jp112sdl/JP6502/Software/README.md

# 6502 system software

This documentation provides necessary insight into software provided in the repository, and it is organized in the following sections:

- [Getting started with provided software](#getting-started-with-provided-software),
- [Building software](#building-software),
- [Detailed description of modules in software folder](#detailed-description-of-modules-in-software-folder).

## Getting started with provided software

Before discussing the details of the contents, I will show how to use sample programs for smoke testing of the soldered board.

I recommend running first couple of programs in slow clock mode, so with external clock module, with Arduino Mega based bus analyzer.

### Connecting Arduino Mega

First, make sure you have the 6502-monitor program installed on your Arduino Mega board. You will find it in `Arduino/6502-monitor` folder.

Connect pins as per following table:

| Expansion port pins | Arduino Mega pins |
| --- | --- |
| D0-D7 (data bus) | 53-39 |
| A00-A15 (address bus) | 52-22 |
| CLK (system clock) | 2 |
| R/W (read/write) | 3 |
| GND | GND |
| +5V | +5V |

**PLEASE NOTE: Connections are reversed for convenience. D0 is connected to pin 53, D1 to pin 51, A00 to pin 52 and A15 to pin 22.**

Also, connect clock module as follows:

| Computer connection | Clock module connection |
| --- | --- |
| CLK input (middle pin on J1) | CLK output |
| UART +5V | +5V |
| UART GND | GND |

It might seem strange that the clock module is powered from UART port, but in fact it doesn't matter which of the power outputs you choose. I use this one, since this one is closes to the clock connector (J1). This is one thing I didn't consider when designing the PCB - I provided GND reference in J1, but the power is missing...

The whole thing will be powered from Arduino via USB - don't worry, the load will not be too high.

### Setting up development environment

Development environment requires the following tools:

- `make` to invoke all the below,
- `cc65` compiler, available [here](https://github.com/cc65/cc65),
- `minipro` software to upload ROM image to EEPROM, available [here](https://gitlab.com/DavidGriffith/minipro/),
- `hexdump` for testing the contents of the binaries,
- `md5sum` to generate binary checksum,
- `rm` and `mkdir` for folder/file manipulation,
- `picocom` for serial communication with the computer (Linux/MacOS),
- `ExtraPuTTy` for serial communication and upload (Windows specific),
- `sz` for loadable module upload via `picocom` (Linux/MacOS),
- `python` to run small utility written in Python to trim loadable modules and add start vector,
- `x6502` to run computer emulator (enables execution of generated binaries on PC), available [here](https://github.com/dbuchwald/x6502) - **please note: this one is optional, still in development, and lagging behind the actual computer.** Simple programs can be executed, but anything more complex than LCD operation (including ACIA/keyboard) don't work just yet.

One important thing to note is that you might need to install FTDI Virtual COM Port drivers, and it applies to all operating systems.

#### Setting up development environment under Linux

By default, Linux distro should contain most of the needed tools. You might need to install `git` to clone `cc65` and `minipro` repositories to build them. The latter requires also `pkg-config` package in Debian/Ubuntu. `sz` might not be available, so check your distro manual for details.

#### Setting up development environment under MacOS

You will probably need `brew` to install `make` and `git`. Tricky part is missing `md5sum` utility, which can be installed using:

```shell
brew install md5sha1sum
```

Other than that, `sz` will probably be missing, so you might need to install this one as well.

#### Setting up development environment under Windows

This one seems to cause most issues, while it's not really that difficult. You need to install [Cygwin](https://cygwin.com/), but while installing, make sure you add the following packages: `python2`, `pkg-config`, `git`, `make`. This should be enough to clone `cc65` and `minipro` repositories, and after building them make sure to issue `make avail` and `make install` respectively to enable invocation from command line.

For serial communication you can use regular PuTTy, but it doesn't have the feature of sending files using XModem protocol, required for loadable module support. Since this is important feature of this hardware/software stack, it's really recommended to use ExtraPuTTy instead.

**PLEASE NOTE:** You might be able to use virtual machines or Windows Subsystem for Linux (WSL) - but neither of the two worked correctly with `make install` target that uses TL866II+ programmer to flash the ROM. YMMV.

### Running the simplest possible program

Now you need to build the first program. Go to `Software/rom/nop_fill` folder and run:

```shell
make clean all test
```

You expect output similar to the following:

```text
$ make clean all test
rm -f ../../build/rom/*.bin \
	rm -f ../../build/rom/*.raw \
	../../build/rom/nop_fill/*.o \
	../../build/rom/nop_fill/*.lst \
	../../build/rom/nop_fill/*.s \
	../../build/rom/nop_fill/*.map \
	../../build/rom/nop_fill/*.d \
	../../build/rom/nop_fill/*.cdep \
	../../build/common/*.o \
	../../build/common/*.lst \
	../../build/common/*.s \
	../../build/common/*.d \
	../../build/common/*.cdep \
	../../build/lib/*.lib
ca65 --cpu 65C02 -Dclock_mode_flag=2  -Dacia_tx_irq=1  -Ddb6502 -I ../../common/include --create-dep ../../build/common/zeropage.d -o ../../build/common/zeropage.o -l ../../build/common/zeropage.lst ../../common/source/zeropage.s
ca65 --cpu 65C02 -Dclock_mode_flag=2  -Dacia_tx_irq=1  -Ddb6502 -I ../../common/include --create-dep ../../build/common/sysram_map.d -o ../../build/common/sysram_map.o -l ../../build/common/sysram_map.lst ../../common/source/sysram_map.s
ca65 --cpu 65C02 -Dclock_mode_flag=2  -Dacia_tx_irq=1  -Ddb6502 -I ../../common/include --create-dep ../../build/rom/nop_fill/nop_fill.d -o ../../build/rom/nop_fill/nop_fill.o -l ../../build/rom/nop_fill/nop_fill.lst nop_fill.s
ca65 --cpu 65C02 -Dclock_mode_flag=2  -Dacia_tx_irq=1  -Ddb6502 -I ../../common/include --create-dep ../../build/common/syscalls.d -o ../../build/common/syscalls.o -l ../../build/common/syscalls.lst ../../common/source/syscalls.s
ca65 --cpu 65C02 -Dclock_mode_flag=2  -Dacia_tx_irq=1  -Ddb6502 -I ../../common/include --create-dep ../../build/common/acia.d -o ../../build/common/acia.o -l ../../build/common/acia.lst ../../common/source/acia.s
ca65 --cpu 65C02 -Dclock_mode_flag=2  -Dacia_tx_irq=1  -Ddb6502 -I ../../common/include --create-dep ../../build/common/blink.d -o ../../build/common/blink.o -l ../../build/common/blink.lst ../../common/source/blink.s
ca65 --cpu 65C02 -Dclock_mode_flag=2  -Dacia_tx_irq=1  -Ddb6502 -I ../../common/include --create-dep ../../build/common/dpad.d -o ../../build/common/dpad.o -l ../../build/common/dpad.lst ../../common/source/dpad.s
ca65 --cpu 65C02 -Dclock_mode_flag=2  -Dacia_tx_irq=1  -Ddb6502 -I ../../common/include --create-dep ../../build/common/core.d -o ../../build/common/core.o -l ../../build/common/core.lst ../../common/source/core.s
ca65 --cpu 65C02 -Dclock_mode_flag=2  -Dacia_tx_irq=1  -Ddb6502 -I ../../common/include --create-dep ../../build/common/keyboard.d -o ../../build/common/keyboard.o -l ../../build/common/keyboard.lst ../../common/source/keyboard.s
ca65 --cpu 65C02 -Dclock_mode_flag=2  -Dacia_tx_irq=1  -Ddb6502 -I ../../common/include --create-dep ../../build/common/lcd.d -o ../../build/common/lcd.o -l ../../build/common/lcd.lst ../../common/source/lcd.s
ca65 --cpu 65C02 -Dclock_mode_flag=2  -Dacia_tx_irq=1  -Ddb6502 -I ../../common/include --create-dep ../../build/common/lcd8bit.d -o ../../build/common/lcd8bit.o -l ../../build/common/lcd8bit.lst ../../common/source/lcd8bit.s
ca65 --cpu 65C02 -Dclock_mode_flag=2  -Dacia_tx_irq=1  -Ddb6502 -I ../../common/include --create-dep ../../build/common/modem.d -o ../../build/common/modem.o -l ../../build/common/modem.lst ../../common/source/modem.s
ca65 --cpu 65C02 -Dclock_mode_flag=2  -Dacia_tx_irq=1  -Ddb6502 -I ../../common/include --create-dep ../../build/common/string.d -o ../../build/common/string.o -l ../../build/common/string.lst ../../common/source/string.s
ca65 --cpu 65C02 -Dclock_mode_flag=2  -Dacia_tx_irq=1  -Ddb6502 -I ../../common/include --create-dep ../../build/common/utils.d -o ../../build/common/utils.o -l ../../build/common/utils.lst ../../common/source/utils.s
ca65 --cpu 65C02 -Dclock_mode_flag=2  -Dacia_tx_irq=1  -Ddb6502 -I ../../common/include --create-dep ../../build/common/via.d -o ../../build/common/via.o -l ../../build/common/via.lst ../../common/source/via.s
ca65 --cpu 65C02 -Dclock_mode_flag=2  -Dacia_tx_irq=1  -Ddb6502 -I ../../common/include --create-dep ../../build/common/via_utils.d -o ../../build/common/via_utils.o -l ../../build/common/via_utils.lst ../../common/source/via_utils.s
ca65 --cpu 65C02 -Dclock_mode_flag=2  -Dacia_tx_irq=1  -Ddb6502 -I ../../common/include --create-dep ../../build/common/vdp.d -o ../../build/common/vdp.o -l ../../build/common/vdp.lst ../../common/source/vdp.s
ca65 --cpu 65C02 -Dclock_mode_flag=2  -Dacia_tx_irq=1  -Ddb6502 -I ../../common/include --create-dep ../../build/common/vdp_text_mode.d -o ../../build/common/vdp_text_mode.o -l ../../build/common/vdp_text_mode.lst ../../common/source/vdp_text_mode.s
ca65 --cpu 65C02 -Dclock_mode_flag=2  -Dacia_tx_irq=1  -Ddb6502 -I ../../common/include --create-dep ../../build/common/sound.d -o ../../build/common/sound.o -l ../../build/common/sound.lst ../../common/source/sound.s
ca65 --cpu 65C02 -Dclock_mode_flag=2  -Dacia_tx_irq=1  -Ddb6502 -I ../../common/include --create-dep ../../build/common/tty.d -o ../../build/common/tty.o -l ../../build/common/tty.lst ../../common/source/tty.s
ca65 --cpu 65C02 -Dclock_mode_flag=2  -Dacia_tx_irq=1  -Ddb6502 -I ../../common/include --create-dep ../../build/common/parse.d -o ../../build/common/parse.o -l ../../build/common/parse.lst ../../common/source/parse.s
ca65 --cpu 65C02 -Dclock_mode_flag=2  -Dacia_tx_irq=1  -Ddb6502 -I ../../common/include --create-dep ../../build/common/menu.d -o ../../build/common/menu.o -l ../../build/common/menu.lst ../../common/source/menu.s
ca65 --cpu 65C02 -Dclock_mode_flag=2  -Dacia_tx_irq=1  -Ddb6502 -I ../../common/include --create-dep ../../build/common/sd.d -o ../../build/common/sd.o -l ../../build/common/sd.lst ../../common/source/sd.s
ar65 r ../../build/lib/common.lib ../../build/common/syscalls.o ../../build/common/acia.o ../../build/common/blink.o ../../build/common/dpad.o ../../build/common/core.o ../../build/common/keyboard.o ../../build/common/lcd.o ../../build/common/lcd8bit.o ../../build/common/modem.o ../../build/common/string.o ../../build/common/utils.o ../../build/common/via.o ../../build/common/via_utils.o ../../build/common/vdp.o ../../build/common/vdp_text_mode.o ../../build/common/sound.o ../../build/common/tty.o ../../build/common/parse.o ../../build/common/menu.o ../../build/common/sd.o
ca65 --cpu 65C02 -Dclock_mode_flag=2  -Dacia_tx_irq=1  -Ddb6502 -I ../../common/include --create-dep ../../build/common/crt0.d -o ../../build/common/crt0.o -l ../../build/common/crt0.lst ../../common/source/crt0.s
cp -f ../../common/none.lib ../../build/lib/common.c.lib
ar65 r ../../build/lib/common.c.lib ../../build/common/crt0.o
ld65  -C ../../common/firmware.ext.cfg -m ../../build/rom/nop_fill/nop_fill.ext.map -o ../../build/rom/nop_fill.ext.bin ../../build/common/zeropage.o ../../build/common/sysram_map.o ../../build/rom/nop_fill/nop_fill.o ../../build/lib/common.lib ../../build/lib/common.c.lib
hexdump -C ../../build/rom/nop_fill.ext.bin
00000000  ea ea ea ea ea ea ea ea  ea ea ea ea ea ea ea ea  |................|
*
00008000
49d01fd92a6a02370364f8eef2ee2c93  ../../build/rom/nop_fill.ext.bin
```

If you remember Ben's video - this is the first program he uploads to ROM. Now, run `make install` to upload the binary to your EEPROM - I assume you put the ROM chip in TL866II+ programmer and it is connected to your machine.

```shell
make install
```

You expect the following output:

```text
minipro -p AT28C256 -w ../../build/rom/nop_fill.ext.bin
Found TL866II+ 04.2.109 (0x26d)
Erasing... 0.02Sec OK
Protect off...OK
Writing Code...  6.78Sec  OK
Reading Code...  0.49Sec  OK
Verification OK
Protect on...OK
```

Plug the ROM back in your board, connect the Arduino to your PC, toggle clock module to manual mode, reset 6502 computer and start serial monitor. Go a few cycles step by step and you should see something similar to the below in serial monitor:

```text
10:13:51.707 -> 000000   1110101011110010   11101010   eaf2  r ea
10:13:52.315 -> 000001   1111111111111111   11101010   ffff  r ea
10:13:52.776 -> 000002   1110101011110010   11101010   eaf2  r ea
10:13:53.201 -> 000003   0000000111111101   10111101   01fd  r bd
10:13:53.585 -> 000004   0000000111111100   10111001   01fc  r b9
10:13:54.074 -> 000005   0000000111111011   10000001   01fb  r 81
10:13:54.576 -> 000006   1111111111111100   11101010   fffc  r ea
10:13:55.562 -> 000007   1111111111111101   11101010   fffd  r ea
10:13:56.020 -> 000008   1110101011101010   11101010   eaea  r ea
10:13:56.511 -> 000009   1110101011101011   11101010   eaeb  r ea
10:13:56.982 -> 000010   1110101011101011   11101010   eaeb  r ea
10:13:57.337 -> 000011   1110101011101100   11101010   eaec  r ea
10:13:57.659 -> 000012   1110101011101100   11101010   eaec  r ea
10:13:57.940 -> 000013   1110101011101101   11101010   eaed  r ea
10:13:58.253 -> 000014   1110101011101101   11101010   eaed  r ea
10:13:58.658 -> 000015   1110101011101110   11101010   eaee  r ea
```

First six lines might be different, but starting from line 7 you should see identical output. If this works, it means your CPU and ROM are working just fine, your clock module and Arduino Mega bus analyzer are attached correctly. Congratulations!

If you have any problems during build, installation or execution - check instructions above again, maybe you missed something.

### More complex programs

After having ran the first one, you can try connecting peripherals to your computer. If you want to follow Ben's videos, keep reading this section, otherwise, skip to [next one](#initiate-warp-speed).

First, let's play with some LEDs. Using the connectors in bottom left corner of the PCB, connect 8 LEDs to VIA2 PORTB lines PB0-PB7, and then, using current limiting resistors of 220Ohm, connect these to ground (also from the VIA2 PORTB connector).

Having these connected, upload `Software/rom/blink_s` to your ROM. After powering on, you should see LEDs blinking in a way similar to what Ben did in his videos. If it works correctly, you can move on to connecting LCD. For now, use it in 8-bit mode with slow clock - just as in Ben's videos.

To do this, connect LCD to breadboard (not to the dedicated LCD port on PCB), and then connect each line as listed below:

| VIA2 Pin | LCD Pin |
| --- | --- |
| PA5 | RS |
| PA6 | R/W |
| PA7 | E |
| PB0 | DB0 |
| PB1 | DB1 |
| PB2 | DB2 |
| PB3 | DB3 |
| PB4 | DB4 |
| PB5 | DB5 |
| PB6 | DB6 |
| PB7 | DB7 |

Also, connect A and VDD connectors to +5V, K and VSS to GND and connect V0 to a middle pin of 10KOhm potentiometer plugged between GND and +5V.

Now upload program `Software/rom/lcd_test` to ROM - when executed, it should display "Merry Christmas!" message on the LCD.

If it works correctly, you have a working CPU, ROM, VIA and address decoder.

### Initiate warp speed

Now it's time to go a bit faster and test the more complex features. Please note: you could keep using the analyzer and external clock with these programs, you just have to remember to build them with `CLOCK_MODE=slow` flag. More details can be found in [building software section](#building-software).

For now let's assume we move to 1MHz clock. To do it, put jumper on two leftmost pins of clock connector (J1). Disconnect external clock and bus analyzer - first one is not needed, second one will not work with high frequencies anyway. Connect your LCD to the onboard LCD port.

First one to test will be serial connection, so upload `Software/rom/serial_wdc_irq`. Now, depending on whether you soldered on FT230X chip or not, connect your board using USB cable to PC (using either MicroUSB or USB-B port), or use external USB->UART connector. Connect to your board using `picocom` with baud rate of 19200.

```shell
picocom -b 19200 /dev/tty.usbserial-HANF88HD
```

When you get "Terminal ready" message, you should see "Hello from WDC65C51 (irq), press any key...". This means that two things are working correctly: interrupt handling and serial communication. The polling counterpart is `Software/rom/serial_wdc`, useful when you want to take the interrupt path out of the picture. Congratulations, you are almost ready to go.

### Keyboard connection

Even if you don't intend to use keyboard just yet, you still need to upload the controller sketch to ATtiny4313. Recommended way of doing that is to use onboard AVR-ISP connector and some kind of AVR programmer. I used USBasp programmer and it works lovely directly from Arduino IDE. The sketch to upload is in `Arduino/keyboard-4313` folder. **PLEASE NOTE:** by default, Arduino IDE will not set fuses of your ATtiny4313 to reflect your clock settings. This can result in unpredictable behavior and/or failure of keyboard connection. Make sure you invoke "Tools->Burn bootloader" before uploading the sketch to ensure correct operation. See [issue #50](https://github.com/dbuchwald/6502/issues/50) for additional details.

After successful sketch upload, flash your rom with `Software/rom/keyboard_test`. Connect your PS/2 keyboard to the port and try pressing some keys - you should see messages on the LCD with confirmation.

### Using the bootloader

Currently only the minimal bootloader is provided, but it should be sufficient for software development without constant need to reflash the EEPROM. To use it, build ROM image in `Software/rom/minimal_bootloader` folder and flash it to EEPROM. To test this functionality, you have to build an example loadable program in `Software/load/hello_world`.

**PLEASE NOTE:** Both the bootloader and sample programs will be built automatically when invoking `make all` directly in `Software` folder.

Upon boot you will be prompted to connect to the PC via serial connection and press Enter key - either in terminal window if keyboard is not connected, or on the keyboard otherwise. Connection details will be displayed on the LCD:

- 19200 baud,
- 8-bit, no parity, 1 stop bit,
- CTS/RTS hardware flow control.

In MacOS/Linux you can use `picocom` for this operation, under Windows I have successfully used [ExtraPuTTy](https://www.extraputty.com/).

After connection is established you need to press enter as prompted (either on PS/2 keyboard or terminal window) and you will be prompted to initiate file transfer. In `picocom` this requires that your send command is set to `sz -X` (see `make terminal` target in `Software/common/makefile`) and you initiate transfer with Ctrl+A followed by Ctrl+S. Enter load file path (i.e. `Software/build/load/hello_world.load.bin`) and press enter. If the transfer fails, try again. `picocom` seems to fail every now and then, while ExtraPuTTy hardly ever has any issues.

In ExtraPuTTy open "Files Transfer" menu item, then "Xmodem" and "Send". Point to loadable module (i.e. `Software/build/load/hello_world.load.bin`) and click "Open" button.

Program should load and be automatically executed. Congratulations, you got yourself working bootloader!

### Installing OS/1

OS/1 is simple operating system, currently being developed for the machine. It already provides bootloader functionality and more is coming every day. **THIS IS WORK IN PROGRESS, SO EXPECT STABILITY ISSUES**

After installing to ROM and booting, it will display basic startup messages on onboard LCD and prompt you to connect via serial port (19200 baud, no parity, 8 data bits, 1 stop bit, CTS/RTS hardware flow control) and confirm connection by sending single char via serial, if no keyboard is connected to PS/2 port or by pressing Enter key on attached PS/2 keyboard otherwise.

Simple prompt will be displayed, and the following commands are currently supported:

- `HELP` - will display simple help message with basic description of the commands,
- `LOAD` - will initiate XModem file receive operation to enable loading loadable modules (see [Using the bootloader](#using-the-bootloader) section for details),
- `RUN` - will run the loaded program,
- `MONITOR` - will run monitor application that can be used to check/alter contents of computer memory,
- `BLINK` - with parameter `ON` or `OFF` will toggle onboard blink LED state,
- `EXIT` - will exit the shell - and go back to it after soft reset.

Loaded programs might fail or fall into infinite loop. To prevent having to reset them, you can press CTRL+X key combination on attached PS/2 keyboard - this will initiate system break operation and should return you back into the shell.

#### Using built-in monitor application

Currently monitor application is fairly limited, but it should provide sufficient functionality for basic troubleshooting. The following commands are supported:

- `GET` with single address (in format `XX` or `XXXX`) will display data from this address and 15 following bytes,
- `GET` with address range (in format `XXXX:XXXX`, zeropage addresses can be substituted with `XX`) will display all the data within given range,
- `PUT` will store provided value (in format `XXXX=XX`) under given address.

Standard commands like `HELP` and `EXIT` are obviously also supported.

## Building software

General rule is simple: `make` should be sufficient for all the build/installation. The following `make` targets are to be used for building software:

- `all` - build the project,
- `clean` - delete all temporary files,
- `test` - dump the contents and checksum of generated binary file,
- `install` - upload generated binary to AT28C256 chip using `minipro` tool,
- `terminal` - connect to the 6502 computer using serial port, please note - currently uses my own device ID as visible under MacOS and most likely needs to be adapted to your build/OS,
- `emu` - run the generated binary in system emulator. Again: suitable for simple programs, more complex ones are not yet supported. So far I needed it only for simple debugging and that's why it is so limited.

Beside the targets, there are three very important build flags:

- `ADDRESS_MODE` - drives the target addressing model by selecting `common/firmware.$(ADDRESS_MODE).cfg`. The only value shipped today is `ext` (also the default if omitted). The `basic` mode for Ben Eater's machine has been **removed**: `common/source/via.s` unconditionally references the third VIA, and the VDP is mapped as well, so `firmware.basic.cfg` had not linked for a long time. If you want to support your own model, create an additional configuration file, as explained in the common sources section below,
- `CLOCK_MODE` - used to control internal delay routines to work with different clock setups. The following modes are supported:
  - `slow` - to be used with external clock module, all delays are basically disabled,
  - `250k` - to be used with Arduino Mega Debugger (my own variant running at approx. 275kHz),
  - `1m` - to be used with 1MHz oscillator,
  - `2m` - to be used with 2MHz oscillator,
  - `4m` - to be used with 4MHz oscillator,
  - `8m` - to be used with 8MHz oscillator.
- `LCD_MODE` - with acceptable values `8bit` and `4bit` (the latter being default if omitted) enables build time selection of LCD interface. If your own build of 6502 computer uses 8-bit interface towards LCD, this will let you use provided software with it. The only thing you might want to check is the LCD data and port definitions at the beginning of `common/source/lcd8bit.s` (or, if you are using your own build with 4-bit mode `common/source/lcd4bit.s`) for symbols `LCD_DATA_PORT` and `LCD_CONTROL_PORT`, as well as their DDR counterparts. The same is possible with 4-bit mode, but there is just one symbol - `LCD_PORT` accompanied by DDR counterpart. Default configuration is obviously immediately compatible with 4-bit onboard LCD connector, and 8-bit interface connected to VIA2 PA for control and PB for data (like in BE6502),
- `ACIA_TX_IRQ` - flag was introduced to enable compatibility with WDC65C51 ACIA chip and acceptable values are `0` and `1`. It controls usage of IRQ request to indicate that transmit operation was completed. When disabled (value `0`), fixed time delay is used to wait for the transmit operation to complete. Rockwell R6551 chips can work with both settings, but `1` is recommended.

Build examples:

```shell
make CLOCK_MODE=slow clean all test install
```

This will build sources with support for slow clocking - any delay routines will be skipped. First, all the binaries will be removed, then built from scratch, hexdump of the resulting binary will be displayed and the binary uploaded to the EEPROM, assuming it's connected via minipro-compatible programmer.

```shell
make CLOCK_MODE=1m all test
```

This command will rebuild only modified modules with support for my own addressing scheme (32K RAM, 24K ROM, VIA at 0x9000) and suitable for 1MHz execution - all delays will be enabled.

## Detailed description of modules in `Software` folder

There are quite many programs in the `Software` folder, making the navigation a bit difficult. This section should support you in navigating provided software library.

### ROM images in `rom` folder

In the `rom` folder you will find the following ROM images:

- `nop_fill` - simplest possible program, composed of 32K of NOP (0xea) instructions. The source itself seems empty, because default fill is defined in the firmware configuration file (`common/firmware.ext.cfg`),
- `blink_s` - first example of a program interfacing with external world, using VIA2 to drive LEDs, as in Ben's videos,
- `blink_c` - modification of `blink_s`, but mixing low-level ASM code for hardware handling and C code for "business logic", shows how to use software stack to write code in C,
- `blink_test` - another blink program, but this one drives the onboard LED through the common library functions instead of touching the VIA directly. The same source is also built as a loadable module, so it doubles as an illustration of what the `BUILD_TYPE=` flag in the `makefile` changes,
- `lcd_test` - modified version of Ben Eater's first LCD program. Modification involves using loops, but runs without RAM, only ROM is used. This program will work only on slow clock (not 1MHz), and will not work with onboard LCD connector. To execute this one, you need to connect LCD via breadboard to VIA2 connectors on the PCB,
- `d_pad_test` - reads the D-pad through the common `dpad` library and reports each direction on the onboard LCD. Built from the same source as `load/d_pad_test`, which is why the folder holds only a `makefile`,
- `keyboard_test` - more complex program presenting integration with onboard keyboard controller, with IRQ driven data transmission, hardware state change detection and pretty interface on the onboard LCD port,
- `serial_test` - simplest possible ACIA/serial testing program, using blocking send/receive operation to send simple message in response to each input on serial terminal,
- `serial_wdc` - ACIA test using polled send and receive, prints "Hello from WDC65C51, press any key...",
- `serial_wdc_irq` - the same test driven by interrupts, prints "Hello from WDC65C51 (irq), press any key...",
- `serial_load_test` - attempt to implement testing program for high serial load, counting incoming characters,
- `modem_test` - barebone modem testing application, sort of bootloader without user interface,
- `play_song` - plays "Mary Had a Little Lamb" on the SN76489, driving the chip directly rather than through the common `sound` library. Shares its source with `load/play_song`,
- `vdp_diag` - reports what the VDP actually does at a cold start, on the **LCD** rather than the screen, because the screen is the part under suspicion. Runs the cold start step by step, then prints text through the same routines BASIC uses, and after each stage checks whether the pattern table in VRAM still matches the ROM. Reach for it before theorising about a bad picture,
- `microsoft_basic` - standalone version of MS Basic interpreter working over serial connection. Loads and saves programs on the SD card - see [BASIC on the SD card](#basic-on-the-sd-card) below,
- `minimal_bootloader` - simplest possible bootloader application that can be used to simplify software development thanks to making ROM flashing unnecessary for each code change,
- `os1` - **work in progress** - basic operating system.

The following table summarizes how each program behaves on this machine. The
`BE6502` column that used to stand next to it is gone with `ADDRESS_MODE=basic`,
which the build no longer supports.

| Program | Execution notes |
| --- | --- |
| `rom/nop_fill` | Works out of the box, slow clock and bus analyzer recommended  |
| `rom/blink_s` | Works out of the box, attach LEDs to VIA2, needs slow clock |
| `rom/blink_c` | Works out of the box, attach LEDs to VIA2, needs slow clock |
| `rom/blink_test` | Works out of the box |
| `rom/d_pad_test` | Works out of the box |
| `rom/lcd_test` | Works out of the box, attach LCD to VIA2, needs slow clock |
| `rom/keyboard_test` | Works out of the box |
| `rom/serial_test` | Works out of the box with R6551, WDC65C51 needs slow clock |
| `rom/serial_wdc` | Works out of the box |
| `rom/serial_wdc_irq` | Works out of the box |
| `rom/serial_load_test` | Works out of the box |
| `rom/modem_test` | Works out of the box |
| `rom/play_song` | Works out of the box, needs the SN76489 fitted |
| `rom/vdp_diag` | Works out of the box, reports on the LCD |
| `rom/microsoft_basic` | Works out of the box |
| `rom/minimal_bootloader` | Works out of the box |
| `rom/os1` | Works out of the box |

### BASIC on the SD card

`rom/microsoft_basic` keeps programs on the card as **plain text**, one BASIC line per text
line, exactly the way `LIST` prints them. There is no tokenised file format: `LOAD` feeds the
file through the interpreter's own line input, and `SAVE` runs `LIST` with the output
redirected. A saved program can therefore be edited on a PC, and it survives changes to the
token table or to the load address.

| Command | Effect |
| --- | --- |
| `LOAD` | read `BASIC.BAS` |
| `LOAD "NAME.BAS"` | read `NAME.BAS` from the root directory |
| `LOAD "$"` | replace the program with a listing of the card, then `LIST` it |
| `LOAD "@"` | replace the program with one sent over the serial port, see below |
| `SAVE "@"` | list the program out over the serial port |
| `SAVE` | write `BASIC.BAS` |
| `SAVE "NAME.BAS"` | write `NAME.BAS` |
| `LOAD "NAME.BAS",8` / `SAVE "NAME.BAS",8` / `LOAD "$",8` | the same with the floppy drive instead of the card, see below |

Both accept any string expression, so `LOAD F$` works too. Names are folded to upper case and
cut down to 8.3; long file names on the card are ignored, only the short name matches.

`LOAD` clears the program first, then inserts every line as if it had been typed - so a text
line without a line number is *executed* rather than stored, and a syntax error stops the load
with the usual message.

`SAVE` creates the file if the card does not have it yet, and it rebuilds the cluster chain
from scratch every time: the old chain is released first, then clusters are taken off the free
list as the listing comes in. The file therefore always ends up exactly as long as the program,
with no leftover tail and no size that disagrees with the chain. Both copies of the FAT are
kept in step, and the free-space fields in the FSInfo block are marked "unknown" afterwards so
a PC counts them again rather than trusting a stale number. A save that fails part way through
gives its clusters back and leaves an empty file rather than something a `chkdsk` would have to
find.

Names that are about to create a new entry are checked first: control characters and the
characters FAT reserves (`" * + , . / : ; < = > ? [ \ ] |`) are refused with `?SYNTAX ERROR`
rather than written into the directory.

Two things the card could do but this does not, on purpose - a 1541 does not do them either,
and the point of `LOAD`/`SAVE`/`LOAD "$"` here is to feel like a C64:

- **one flat directory.** Files live in the root and nowhere else; a subdirectory on the card
  shows up in `LOAD "$"` as `DIR` and cannot be entered,
- **no timestamps.** There is no clock in the machine, and CBM DOS has no date field at all, so
  every entry gets the same fixed stamp of 2026-01-01 12:00. It is there only because a blank
  date field makes some tools on a PC complain.

Actual limitations:

- **the root directory cannot grow.** Once its slots are used up, `SAVE` reports
  `?DIRECTORY FULL` - the same wall a 1541 hits at 144 entries, just at a different number.
  How many depends on how the card was formatted: one entry per 32 bytes of the root
  directory's clusters, and long file names written by a PC eat several entries each.

The card does **not** have to be in the slot when the machine is switched on. `LOAD` and `SAVE`
each bring it up from scratch first - the same sequence that runs at power-on - so a card can
be put in later, taken out and put back, or swapped for a different one between commands. The
swap is the reason this happens every time rather than only after a failure: carrying one
card's layout over to another would have `SAVE` writing over whatever lives at those sector
numbers. It costs roughly 0.4 s per command at 1 MHz, and about twice that for `SAVE`, which
reads the BPB again for the fields the boot-time init does not keep.

Error messages: `?NO CARD`, `?NO SUCH FILE`, `?FILE TOO SMALL`, `?DISK FULL`,
`?DIRECTORY FULL`, `?WRITE ERROR`, `?CARD ERROR`.

The card needs an MBR partition table with a FAT32 partition in one of its four entries, of
type `$0C` (FAT32 LBA, what Windows and most new cards use) or `$0B` (what macOS writes when it
formats a card; `diskutil list` calls it `DOS_FAT_32`). A card formatted without a partition
table is `?NO CARD`, as is one that does not answer. After a `?NO CARD`, `PEEK(73)` says how
far the mount got:

- 100 and up: the card did not come up - 100 plus the number of the command it gave the wrong
  answer to (100 CMD0, 108 CMD8, 155 CMD55, 141 ACMD41), and `PEEK(74)` is that answer, 255
  for none at all. 100 with 255 is also what an empty slot gives.
- 0: its first sector could not be read,
- 1: the first sector has no boot signature,
- 2: no FAT32 partition was found,
- 3: the partition's boot sector could not be read,
- 4 to 7: that boot sector is not one this can use.

A card that came up leaves 7 there. After a failed read (0 or 3), `PEEK(74)` is what the card
sent instead of its answer or the start of the data, 255 for nothing.

A card may take up to 100 ms to deliver a sector. The wait for it is scaled with the clock
the ROM is built for, to the same 320 ms at every clock - it used to be a fixed count, which
was 320 ms at 1 MHz but only 80 ms at 4 MHz, too short for some cards.

The card is driven the way GeckOS does it: CMD0 is sent up to ten times, as some cards ignore
the first ones after power-up; every command - reads and writes of sectors too - is preceded by
a byte of clocks with the card selected and followed by eight clocks with it deselected; and
the two CRC bytes after a sector that is read are clocked out, though not checked. Some cards
do not mind either way; one here, an 8 GB card, missed every command that came without.

**The keyword table used to cap how many statements could exist**, at 256 bytes, because
`program.s` walked it with an 8-bit index and the terminator at offset 256 was unreachable - the
scan looped forever and the machine hung on the first ENTER, with everything up to that point
looking perfectly healthy. The seven places that read it now carry a page alongside the index,
so the cap is gone; section 5.3 of MEMORY_MAP.md has the mechanism. What is left as the real
limit on new statements is the space in front of `EXTCODE` at $e700, which is 1014 bytes since
the XMODEM tables left the ROM - section 5.4 of MEMORY_MAP.md.

**If you extend this code, read [section 5.2 of MEMORY_MAP.md](MEMORY_MAP.md) first.** The body
of `common/source/db6502_sdbasic.s` and the allocating write path at the end of
`common/source/libfat32.s` are deliberately linked into their own ROM block `SDCODE` at `$ec00`
instead of into `CODE`, and their variables into `BASBUF` instead of `BSS`. Growing `CODE` past
roughly `$dc50` moves every library module behind `msbasic.o` to a new address, and on this
board that alone kills the VDP picture - a ROM built from unchanged sources plus 1110 dead
filler bytes reproduces it. That is a hardware-level effect, not a bug in this code.

**Put new code in `EXTCODE2` at `$f900`, and nowhere else.** `SDCODE` and `EXTCODE` are both
full in practice and, more to the point, inserting into either pushes everything behind it to a
new address - which on this board is the failure above. `EXTCODE2` sits behind every other
segment in the image, so an addition there moves nothing at all. It has 1761 bytes free and
`COLOR` is its first tenant, confirmed on the hardware.

That is not a style preference. `COLOR` was first written into `SDCODE`, where its 25 bytes
push the rest of the block up: the machine comes up drawing the right characters through the
wrong glyphs, permanently, and never recovers. The same statement in `EXTCODE2` runs. The
effect is address-dependent rather than size-dependent - `CLS` shifting the same block by 37
bytes is harmless, 62 bytes is not - so there is no safe amount to insert. Sections 5.1.1 and
5.2.3 of MEMORY_MAP.md have the measurements, including what has already been ruled out on the
hardware so it does not get chased again.

`LOAD "$"` ends the way a C64 directory does, with a line saying how much room is left:

```text
0 "SD CARD"
1 "HELLO.BAS        1"
2 "PROG.BAS         6"
3 "78566 BLOCKS FREE"
```

A block is 512 bytes, the same unit the size column uses. The figure comes out of the FSInfo
block rather than from counting the FAT - on an 8 GB card that count would mean reading some
eight thousand sectors, about thirteen minutes. `SAVE` therefore keeps the FSInfo count in step
as it takes and returns clusters, instead of marking it unknown; `fsck_msdos` confirms the
number afterwards. A card that arrives without a usable count is told apart from one with a
real zero: the line then reads `??? BLOCKS FREE`.

### Sending a program over the serial port

`LOAD "@"` takes the program from the ACIA instead of the card, and `tools/basicsend.py`
sends it from the Mac over an FTDI cable. It is the same plain text again - the same lines
`LIST` prints, the same lines a `.BAS` file holds - so a program can be written in a proper
editor, sent over, tried out, edited on the machine and saved to the card, with nothing
converted anywhere along the way.

```bash
./tools/basicsend.py SNAKE.BAS
```

Then type `LOAD "@"` on the machine. `SAVE "@"` sends a program the other way,
with `tools/basicrecv.py` catching it:

```bash
./tools/basicrecv.py SNAKE.BAS
``` Either order works: the receiver repeats its "ready"
every half second while it waits, so the tool picks one up whenever it arrives. The status
line counts the lines as they land, and `OK` comes back when the last one is in.

The tool takes a path, or a bare name it looks up in `basic/`:

| | |
| --- | --- |
| `basicsend.py --list` | what is in `basic/`, with line and byte counts |
| `basicsend.py HANOI.BAS` | send it |
| `basicsend.py -p /dev/tty.usbserial-XXXX prog.bas` | pick the port by hand |
| `basicsend.py --as-is prog.bas` | do not touch the case of anything |

`basicrecv.py` refuses to overwrite a file unless you pass `-f`, and writes nothing at all if
the listing stops without its end marker - half a program looks exactly like a whole one, and
under the name of the real thing it would be worse than none. `-` writes to standard output
instead of a file. Ctrl+C on the machine gets it out of a `SAVE "@"` with nothing listening.

By default the sending tool upper-cases everything outside string literals, because the tokeniser only
knows upper case keywords - `10 print "hello"` would be a syntax error, and `10 PRINT "hello"`
is what you meant. Blank lines are dropped, and a line over 78 characters is refused before
anything is sent rather than being silently cut short at the far end.

`LOAD "@"` runs `NEW` first, exactly as `LOAD` from the card does, so what arrives replaces
what was in memory. A line without a line number is *executed* rather than stored, and a
syntax error ends the transfer with the usual message - the tool is told and stops rather than
sitting out its timeout. Ctrl+C on the machine also ends it.

One line at a time, each acknowledged before the next is sent. That is not for the sake of the
wire - 19200 baud is nothing - but because inserting a line into a long program takes longer
than sending one, and streaming would overrun the 256 byte receive buffer inside a second.

Nothing appears on the machine until the tool has the port open, and that is the hardware
rather than the software: the 6551 holds its transmitter off while `/CTS` is high, and `/CTS`
comes from the far end's RTS. So `LOAD "@"` on its own sits quietly at `000` until something
opens the port. Ctrl+C gets you out of it at any point, and starting a fresh `LOAD "@"` throws
away anything a previous attempt left on the wire - no power cycle needed in between.

### The floppy drive: `LOAD "NAME.BAS",8`

With `,8` behind the name, `LOAD`, `SAVE` and `LOAD "$"` go to a floppy drive instead of the
card - device 8, the way a C64 has its 1541:

```basic
LOAD "$",8
LIST
LOAD "HELLO.BAS",8
SAVE "HELLO.BAS",8
```

The drive is a PC floppy with a Raspberry Pi Pico as its controller, on the 6551 through a
switch that otherwise connects the FTDI. The wiring, the protocol and the state of the
build are in [`../Schematics/FLOPPY_PICO.md`](../Schematics/FLOPPY_PICO.md). It speaks the
protocol of `LOAD "@"` and `SAVE "@"` with a command in front, and answers like a 1541:
anything that goes wrong shows up as `?62,FILE NOT FOUND`, `?72,DISK FULL`,
`?26,WRITE PROTECT ON` and so on, on the screen and the LCD. A drive that does not answer
within about ten seconds - the switch on the Mac side, say - is `?DEVICE NOT PRESENT`.
Files are text, as on the card, and the same name rules apply.

Until the drive is built, `tools/drivesim.py` plays it with a folder on the Mac, over the FTDI
with the switch on the Mac side:

```
./tools/drivesim.py                    # serves basic/
./tools/drivesim.py -p /dev/tty.usbserial-XXXX ~/floppy
./tools/drivesim.py -v                 # log every byte on the wire
```

As with `LOAD "@"`, the 6551 sends nothing until the tool has the port open, and on the Mac
the first byte after that is lost. So once the port has settled the tool sends ENQ, and BASIC,
if it is waiting for an answer, sends the command again - the tool may be started before the
command or within the ten seconds BASIC waits.

It treats the folder as a 1.44 MB disk, so `LOAD "$",8` shows how much of that is left and a
save that does not fit gets `?72,DISK FULL`. With `--stdio` it talks over standard input and
output instead, which is how the GeckOS emulator runs it:
`jp6502emu -A "tools/drivesim.py --stdio basic" build/rom/microsoft_basic.ext.bin`.

### The `SOUND` statement

`rom/microsoft_basic` adds one statement to the interpreter beyond `LOAD`, `SAVE` and `EXIT`:

```basic
SOUND frequency, duration
```

`frequency` is in Hz, `duration` in hundredths of a second. The note plays on channel 1 of the
SN76489 at full volume, and `SOUND` returns once it has finished, so notes queue up naturally:

```basic
10 FOR N=1 TO 8
20 READ F
30 SOUND F,25
40 NEXT N
50 DATA 262,294,330,349,392,440,494,523
```

The chip is not given a frequency but a 10 bit divider, and the note it produces is
`clock / (32 * divider)`. The SN76489 runs on the same oscillator as the CPU, so the clock is
the one the ROM is built for (`CLOCK_MODE`), and `SOUND` works the divider out for it - at
4 MHz that is `125000 / frequency`. A divider outside 1..1023 is `ILLEGAL QUANTITY`, which
puts the usable range at **122 Hz to about 8 kHz at 4 MHz** (31 Hz to 2 kHz at 1 MHz, 61 Hz
to 4 kHz at 2 MHz); towards the top end the steps between neighbouring dividers get audible.
The note table in `common/include/sound.inc`, which the startup chord and the OS/1 `BEEP`
play from, is worked out for the clock the same way.

The port directions are set up by `sound_init` during `_system_init`, long before the `OK`
prompt, so nothing has to be prepared first. Every `SOUND` mutes the channel again when it
returns.

The speaker is in series with a MOSFET (2N7000), whose gate is pulled up with 10k and pulled
down by a second 2N7000 whose gate is CB2 of VIA2 - an inverter: CB2 high or not driven is
off, low is on. After a reset CB2 is an input, pulled up with 10k (a 6522 other than the
W65C22S has a pull-up of its own there, which is why a pull-down on the switch did not work),
so the speaker stays off while the SN76489 plays whatever its registers came up with;
`sound_init` silences the chip and only then drives CB2 low. A 100µF capacitor in front of the
speaker keeps DC out of it, 10k from its minus side to ground keep it charged while the
speaker is off, and 100Ω in series keep the output of the chip near the 10 mA it is rated
for. A ROM that does not drive CB2 low stays silent.

Channels 2 and 3 and the noise generator are not reachable from BASIC. They are one `POKE` away
though - `PORTA` at 34817 carries the data bus and `PORTB` at 34816 the write strobe:

```basic
900 POKE 34817,B : POKE 34816,2 : POKE 34816,0 : POKE 34816,2 : RETURN
```

Add 32 for channel 2, 64 for channel 3 and 96 for noise to both the latch byte
(`128 + (N AND 15)`) and the volume byte (`144` for full, `159` for off).

### Example programs in the `basic` folder

`basic/HANOI.BAS` is plain text in the format `LOAD` expects, so it goes onto the card as it
is. Towers of Hanoi for 3 to 7 disks: pick `P` and you move the disks yourself, pick `W` and
the machine solves it in front of you. The pegs are drawn after every move and the SN76489
clicks as each disk lands, lower disks on a lower note.

```
   |       |       |
  ***      |       |
 *****     |       *
------- ------- -------
   1       2       3

 1 MOVES SO FAR, 7 IS THE BEST
FROM,TO (0,0 GIVES UP)? 1,3
A DISK CANNOT SIT ON A SMALLER ONE.
```

Two things in it are worth reading if you write BASIC on this machine.

The watch mode has no recursion to work with - `GOSUB` takes no arguments and keeps no locals -
so the frames of the usual `hanoi(k, from, to, via)` live in five arrays (`SN`/`SA`/`SC`/`SB`)
with a stage number `ST` per frame: 0 means the disks above still have to be cleared away, 1
that the big disk can move now, 2 that the frame is done.

The move checker tests one thing per line and leaves as soon as something is wrong, rather than
writing the conditions as one expression. `AND` here does not short-circuit, so a typed `4,1`
in `IF ER=0 AND H(FP)=0` would still evaluate `H(4)` and stop the program with `?BS ERROR`.

Nothing in it needs anything this BASIC does not have. `CONFIG_SMALL` removes `GET`, there is
no `ELSE` and no `STRING$`, so input is line-based, every branch is a line number and the
padding strings are built with `FOR` loops.

### The `CLS` statement

`CLS` clears the screen and puts the cursor in the top left corner. It takes no arguments.

It is not what `CLEAR` does. `CLEAR` is stock MS-BASIC and has nothing to do with the display:
it throws away every variable and array, hands the whole of string space back, resets the
`DATA` pointer and unwinds the `FOR` and `GOSUB` stacks. The program text survives. Reach for
it when a program has filled memory with strings, not when the screen is untidy.

`tty_config` can have more than one output switched on, so `CLS` treats each one on its own
terms: the VDP has a routine for it, and a serial terminal is sent `ESC[2J ESC[H`. That escape
sequence goes straight to the ACIA rather than through the console writer, which would put the
bracket and the letters on the VDP as text as well. The LCD is left alone - it is the panel,
not a console.

### The `COLOR` statement

```basic
COLOR foreground, background
```

Both are 0 to 15 out of the TMS9918A palette. Text mode has no colour table, so the background
is the backdrop and these two are the only colours on the screen. Anything above 15 wraps.

| | | | |
|---|---|---|---|
| 0 transparent | 4 dark blue | 8 medium red | 12 dark green |
| 1 black | 5 light blue | 9 light red | 13 magenta |
| 2 medium green | 6 dark red | 10 dark yellow | 14 gray |
| 3 light green | 7 cyan | 11 light yellow | 15 white |

`COLOR 15,4` is what the machine starts with.

**This is one of the few things `POKE` cannot do.** Both halves of a VDP register write go to
the same control port at 32897, so `POKE 32897,246 : POKE 32897,135` looks like it should set
register 7 - and it does nothing at all, without an error. `POKE` assembles to
`sta (LINNUM),y`, and the dummy read that addressing mode performs on the target one cycle
before the write is itself a VDP access. The chip wants about 8 µs between two, so the write
is lost and the pair never completes. It is the same access time that used to leave the screen
dark at cold start. `COLOR` goes through `vdp_write_register`, which waits between the halves.

### Graphics mode: `SCREEN` and `PLOT`

```basic
SCREEN 0            back to text, 40x24
SCREEN 1            graphics, 256x192

PLOT x, y, colour
LINE x1, y1, x2, y2, colour
CIRCLE x, y, radius, colour

SPRITE n, x, y, pattern, colour
VPOKE address, value
```

`x` is 0 to 255, `y` is 0 to 191, `colour` is 0 to 15 out of the palette listed under
`COLOR`. Colour 0 clears the pixel and leaves the background showing; 1 to 15 set it.

```basic
10 SCREEN 1
20 FOR X=0 TO 255
30 PLOT X, 96+SIN(X/16)*80, 15
40 NEXT X
```

**One colour per eight pixels.** The TMS9918A stores a foreground and a background colour for
each horizontal run of eight pixels, not for each pixel. Plotting a red dot therefore recolours
whatever else is already lit in the same group of eight. There is no way around it short of a
full off-screen copy of the screen, and this machine has no 6 KB of RAM to spare for one. The
background stays black, the way `SCREEN 1` leaves it.

```basic
10 SCREEN 1
20 CIRCLE 128, 96, 60, 15
30 PRINT "TEXT AND PICTURES AT ONCE"
```

**Sprites** are 8x8 and unmagnified, which leaves 256 shapes in the 2 KB at $1800 and keeps one
shape down to eight bytes. `n` is 0 to 31; `y` of 192 or more parks a sprite off the screen,
which is how one is hidden. `SCREEN 1` parks all 32 and blanks the shapes, so nothing appears
until you put it there.

Shapes go in with `VPOKE`, one byte at a time, because `POKE` cannot reach VRAM at all - the
reason is under `COLOR` above. Pattern `p` lives at `6144 + p*8`:

```basic
10 SCREEN 1
20 FOR I=0 TO 7
30 READ B : VPOKE 6144+I, B
40 NEXT I
50 DATA 60,126,219,255,189,195,102,0
60 FOR X=0 TO 248
70 SPRITE 0, X, 90, 0, 15
80 NEXT X
```

`VPOKE` writes anywhere in the 16 KB of VRAM, so it also reaches the bitmap, the colour table
and the sprite attributes. That is useful and it will take the display apart just as readily as
`POKE` takes the machine apart.

Two details of the chip are dealt with rather than passed on: a sprite appears one line below
the `y` in its attribute entry, so the stored value is one less than you asked for; and a stored
`y` of 208 tells the chip to stop reading the table there, which would silently switch off every
sprite after it, so that one value is nudged by a line. What is not dealt with, because it
cannot be, is that only four sprites are drawn on any one scanline. The fifth simply is not
there.

**The console keeps working in graphics mode.** The bitmap occupies the VRAM the font lives in,
so the two cannot both be the screen - but the font is still in the ROM, and characters are
drawn into the bitmap instead, eight bytes at a time. `PRINT` works, and so does seeing what
you type.

The cell layout falls out of the bitmap addressing: for a character at column `c` and row `r`
the eight rows of pixels are eight consecutive VRAM addresses, so one address gets written and
eight bytes go out. The colour is written too, so text stays readable over whatever was drawn
underneath.

32 columns by 24 rows, against 40 by 24 in text mode. **It scrolls, and it is slow.** A
character row is exactly one 256-byte page of the bitmap, so moving the picture up a row is 23
page moves in the shape table and 23 in the colour table - 11776 bytes through the processor
twice, about a third of a second. There is no way round it: the 9918 has no block move, and in
this mode every cell has its own pattern, so the name table cannot be rotated the way it can on
a text screen. What you see is the copy sweeping down the screen, which reads as the scroll it
is.

If a third of a second a line is too slow - a long `LIST` is the case that hurts - the jump is
one constant, `GTX_SCROLL_ROWS` in `db6502_extra.s`. Jumping further moves nearly the same
bytes but does it once every that many lines, so the cost per line falls with the jump: about
90 ms at four rows, about 45 ms at eight. The screen then jumps rather than slides.

`SCREEN 0` reloads the font and goes back to the 40 column text screen; so does the reset
button, and after a power-on the console is always the text one.

`LINE` takes both endpoints inclusive and is Bresenham, so it never strays more than half a
pixel from the true line. `CIRCLE` is the midpoint algorithm and holds to the same half pixel.
Both cost what `PLOT` costs, per pixel drawn.

A circle may sit anywhere, including partly off the screen - it is clipped point by point and
drawn as far as it fits. `CIRCLE x, y, 0, c` is one dot.

```basic
10 SCREEN 1
20 FOR R=8 TO 88 STEP 8
30 CIRCLE 128, 96, R, 15
40 NEXT R
```

**Speed.** A single `PLOT` is a read-modify-write of the bitmap byte plus a write to the colour
table, three VRAM addresses in all, about 250 µs. That is roughly 4000 pixels a second, so the
example above draws in about a fifteenth of a second, a full width `LINE` takes about 64 ms,
and filling the whole screen dot by dot would take ten seconds. `SCREEN 1` itself writes 13056
bytes and takes about a quarter of a second, with the screen blanked while it does.

Runs of eight pixels that fall inside one byte could be written whole - two VRAM addresses
instead of twenty-four, worth roughly a factor of thirteen on horizontal lines. That is not
implemented. It is not as simple as it sounds: in this mode consecutive bytes are eight
addresses apart rather than adjacent, so it does not fall out of the VDP's auto-increment and
needs its own path with masked ends.

The VRAM layout is the usual full-screen bitmap: 6144 bytes for the bitmap at $0000, 6144 for
the colour table at $2000, 768 for the name table at $3800. Sprites are switched off by putting
$D0 in the first sprite's Y byte - the attribute table is not part of what `SCREEN 1` fills, and
an uninitialised one has the chip drawing 32 sprites out of whatever the VRAM came up with. The
2 KB hole between the bitmap and the colour table, $1800-$1FFF, is where a sprite pattern table
would have to go: those need a 2 KB boundary, so the space behind the name table cannot hold
one.

### The `KEY` function

```basic
A = KEY(0)
```

The code of a key if one is waiting, zero if none is. It does not wait, which is the whole
point: `INPUT` holds the machine until ENTER, so without this nothing written in BASIC can
steer a sprite, poll for a fire button, or offer a way out of a loop.

The argument is required by the way MS-BASIC dispatches functions and is ignored, the same way
`RND(0)` reads.

Both the serial port and the PS/2 keyboard feed it. Print the codes to find out what your
keyboard sends:

```basic
10 K=KEY(0)
20 IF K>0 THEN PRINT K
30 GOTO 10
```

Upstream MS-BASIC has `GET` for this, but `CONFIG_SMALL` leaves its routine out of the build
entirely, so restoring the keyword would mean compiling the routine and growing `CODE` - see
section 5.2.3 of MEMORY_MAP.md for why that is the one change to avoid.

### The console

40 columns by 24 rows in text mode, 32 by 24 in graphics. A line that runs off the right edge
wraps onto the next row, and the screen scrolls when it runs off the bottom - in graphics mode
that scroll costs about a third of a second, see the note under the graphics statements.

`PRINT` counts its own columns for the comma and `TAB` zones, and knows nothing about the
console, so a very long line can wrap somewhere the zones did not expect.

### Stopping a program

`Ctrl+C` breaks a running program and a running `LIST`, and prints `BREAK IN` with the line
number. `CONT` carries on from there.

`Ctrl+X` is a different thing entirely and lives a level lower: the keyboard controller sends
`$18` for it, the interrupt handler picks that off before it ever reaches the input buffer, and
the machine restarts. It works no matter what BASIC is doing, including inside a `SOUND` that
has not finished, which `Ctrl+C` cannot do - the check happens between statements.

### The d-pad

Four buttons on VIA2 port B, active low, so a pressed button reads as a zero bit. Nothing has
to be set up first - `_blink_init` runs during boot and leaves those bits as inputs.

```basic
B = PEEK(34816)
IF (B AND  8)=0 THEN REM up
IF (B AND 64)=0 THEN REM down
IF (B AND 16)=0 THEN REM left
IF (B AND 32)=0 THEN REM right
```

`(B AND 120)=120` is "nothing pressed", which makes a serviceable "press any key to start" and,
counted round a loop, a seed for `RND`. Bit 7 is the LED and bits 0 and 1 are outputs as well -
writing to the port will turn the LED on and off, and is otherwise best left alone.

`basic/DPAD.BAS` steers a sprite with it, which is about twenty lines. `basic/SNAKE.BAS` is a
game on the graphics screen: the field is 8x8 cells, and each one is drawn with eight `VPOKE`s
rather than sixty-four `PLOT`s, because a character row of the bitmap is one page of VRAM and
its eight rows of pixels are eight consecutive addresses. Collisions come out of an occupancy
array rather than by walking the body, so a long snake costs no more per move than a short one.

Sprites are the fast way to move something: two bytes go to the attribute table and the chip
does the rest, where the same movement drawn into the bitmap is a few hundred writes. What they
will not do is a snake - only four sprites appear on any one scanline, and a snake lying flat
is a row of segments on the same line.

### Cold start and warm start

After a **power-on** the machine goes straight into a cold start. There is nothing else it
could sensibly do: the SRAM comes up holding whatever it feels like, so there is no program to
keep and no prompt worth showing.

After a **reset** the RAM still holds the program that was in it, and there the choice matters,
so the question comes back:

```text
Cold start [C] or warm [W] start?
```

`C` clears the program and starts fresh, `W` keeps it and returns to the `OK` prompt.

The two cases are told apart by a six-byte signature in `BASBUF`, stamped on the way into the
first cold start and never cleared afterwards. Finding it again means the RAM survived, which
means this was a reset. `BASBUF` works for this because nothing zeroes that page at boot - the
same property that forces `_start_msbasic` to set `sd_loadmode` and `sd_savemode` by hand.

Six bytes of ASCII rather than a two-byte bit pattern on purpose: an SRAM does not come up
uniformly random, it comes up in patterns, and a short signature built from the kind of bytes
an SRAM likes is exactly the one that appears by accident and sends the machine into a warm
start over garbage.

### The panel

The 20x4 LCD is a four line panel, and the LED behaves like the one on a 1541 - lit while the
card is in use, out again when the command finished, still lit if it did not:

```text
Microsoft BASIC
21817 BYTES FREE
SD READY
SAVE PROG.BAS   120
```

The banner and the free memory line are repainted at every direct mode prompt, so the panel
puts itself back together after anything that disturbs it; the card line follows each mount,
and the bottom line follows the transfer. `BYTES FREE` is the figure `PRINT FRE(0)` gives.

The counter is lines: read for `LOAD`, written for `SAVE`, listed for `LOAD "$"`. Lines rather
than 512 byte blocks because that is the unit these files come in - a BASIC program of a few
hundred bytes is nought blocks from beginning to end, and a counter that never moves is worse
than no counter. It sticks at 999. Column 19 is
never written: reaching the end of the last row makes `lcd_wrap_line` scroll the whole display
and wait 150 ms, which would throw the line away and make every update slow. For the same
reason the cursor is parked at the top of the display before the card is touched - `sd_init`
prints `SD not initialized` wherever the cursor happens to be.

### Loadable programs in `load` folder

All the programs in the `load` folder are to be uploaded to the 6502 computer over serial port with XMODEM protocol and require ROM to be flashed with software capable of receiving them. Currently this is `rom/modem_test` and `rom/minimal_bootloader`. Following list describes them in more detail:

- `load/d_pad_test` - exercises the D-pad through the common `dpad` library and reports what it reads on the onboard LCD. Also built as a ROM image by `rom/d_pad_test` from this same source,
- `load/hello_world` - simple program to illustrate difference between assembly and C code,
- `load/hello_world_c` - as above, but written in C,
- `load/monitor` - work in progress implementation of the monitor program (moved to OS/1 image),
- `load/play_song` - plays "Mary Had a Little Lamb" on the SN76489. It talks to the chip itself and only takes the bit definitions from `sound.inc`, so it does not depend on the common `sound` library. Also built as a ROM image by `rom/play_song`,
- `load/sysinfo` - simple program to display system information, now embedded in OS/1 image.

As for software compatibility - all the loadable modules require bootloader, and this one, in turn, requires ACIA for operation, so by design these are not compatible with vanilla BE6502.

### Loadable modules explained

There is one thing important to consider when working with loadable modules. The idea behind them is to have the possibility to run the same code from RAM and ROM, preferably preserving the former if possible and reducing the loadable file size. The idea is to be able to execute common functions stored in ROM from the code running in RAM.

The naive approach is to bundle every function the module calls into the module
itself. It works, and it is what you get without doing anything special, but the
binary then carries its own copy of code that already sits in ROM, and a ROM
update leaves that copy behind.

The alternative is what `load/hello_world` does. It calls `writeln_tty`, so it
uses `_tty_writeln` from the common library - and the whole binary is 286 bytes,
nowhere near enough to contain it. None of the common code is bundled. The
references are satisfied by stub functions defined in `common/source/loadlib.s`,
each of which is a jump through a vector in the dedicated range in ROM
(0xf800-0xfff9). This indirection layer enables updates to ROM without needing
to recompile all the loadable modules. The only requirement is to keep the order
of the calls intact and to add new functions to `common/source/syscalls.s` at the
end, so that previously defined addresses stay where they are.

Defining new shared function requires the following:

- implementation of the code in `common/source` folder,
- implementation of the interface include in `common/include` folder,
- adding this new function to `common/source/syscalls.s` module,
- adding stub function to `common/source/loadlib.s` module,
- adding new objects to `rom/minimal_bootloader/makefile` and `rom/modem_test/makefile`.

The list above should help you understand how this code reusability has been achieved.
