jp112sdl/JP6502/images/breadboard_crop.jpeg

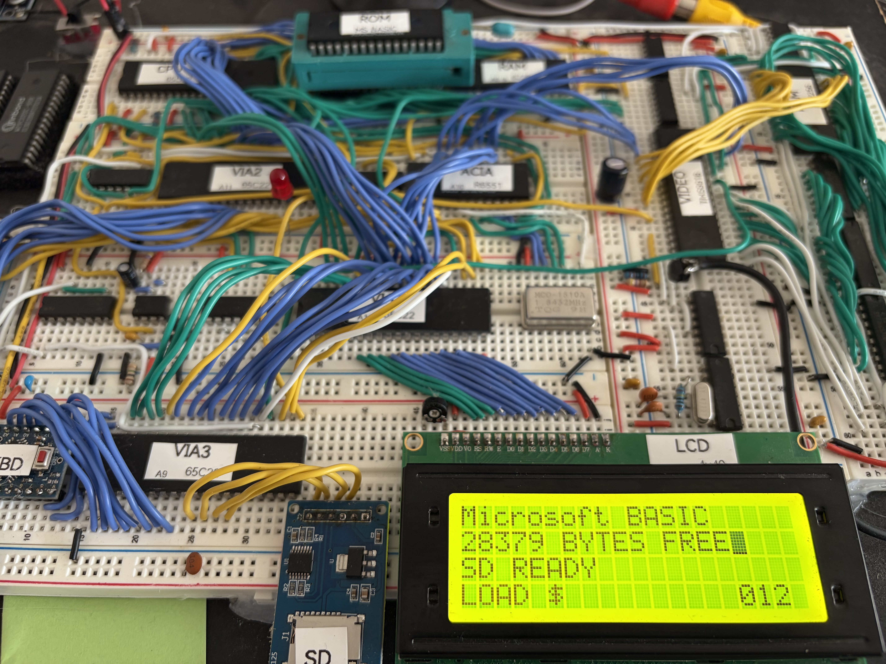
images/breadboard_crop.jpeg
