jp112sdl/JP6502/(commit log)

2026-08-08 jp modsupdate kicad version
2026-08-08 update code
    [firmware.ext.cfg, load.cfg]
2026-08-08 Phase1 done
    [firmware.ext.cfg]
2026-08-11 Add SD card LOAD/SAVE to MS-BASIC, with a drive light and status panel
    Programs live on the card as plain text, one BASIC line per text line,
    exactly the way LIST prints them - LOAD feeds the file through the
    interpreter's own line input and SAVE runs LIST with the output
    redirected, so a saved program can be edited on a PC.
    LOAD / LOAD "NAME.BAS" read a file
    LOAD "$" list the card, ending on a BLOCKS FREE line
    SAVE / SAVE "NAME.BAS" write a file, creating it if it is not there
    SAVE rebuilds the cluster chain from scratch every time: the old chain is
    released first, then clusters are taken off the free list as the listing
    comes in, so the file is always exactly as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
    [applesoft.cfg, cbmbasic1.cfg, cbmbasic2.cfg, firmware.basic.cfg, firmware.ext.cfg, kb9.cfg, kbdbasic.cfg, microtan.cfg]
2026-08-11 Auto-confirm the MS-BASIC startup prompts and share init.s
    Cold start asked "MEMORY SIZE" and "TERMINAL WIDTH" on every boot. Both
    questions only make sense on a machine whose RAM size and terminal are
    unknown at build time - here the memory map is fixed and WIDTH/WIDTH2
    are set in defines_db6502.s, so the answer was always an empty line.
    CONFIG_NO_INIT_PROMPTS now skips both blocks and lets the code fall into
    the RAM probe, which is exactly what confirming with Enter did. Frees 99
    bytes in the ROM build.
    That made the missing DB6502 hard limit in the loadable build's copy of
    init.s a real problem rather than a latent one: with no prompt there is
    no way to answer with a number any more, so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
2026-08-15 Add an XMODEM/CRC uploader for the minimal bootloader
    Sends the .load.bin files from build/load to the 6502 over the serial
    port, driving the receiver in common/source/modem.s.
    That receiver is not quite stock XMODEM, so a generic tool does not work
    against it. Three details it gets wrong:
    * A block is 133 bytes on the wire, not 132 - modem.s reads 132 bytes
    after the SOH (block number, its complement, 128 data bytes, two CRC
    bytes).
    * The handshake is not "wait for a C". The prompt modem.s prints
    contains the letter twice in "XMODEM/CRC", so a tool watching for a
    bare C starts transmitting in the middle of the prompt. This one
    waits for the C that follows the promp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
    [xmodem_send.py]
2026-08-15 Rewire the ATtiny keyboard controller and add a German keymap
    The controller now talks to the VIA on different pins: data on PD3,
    IRQ on PD2, the handshake lines on 9 and 8, and the eight data lines
    reversed to {17..10}. The previous assignment did not match the wiring
    on this board.
    PS2Keymap_German is added and made the default for begin(), and the US
    map is corrected to lower case letters - the shifted variants are what
    the shift table is for, so the unshifted table was producing capitals
    for every key. Enter stays PS2_ENTER (13), which is the KEY_ENTER the
    6502 side expects in common/include/keyboard.inc.
    Also ignore __pycache__, now that there are Python tools in the tree.
    Co-Authore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
2026-08-15 Ignore .hex build output
    The Arduino toolchain drops .hex files next to the sketch on every
    build, and no .hex is versioned here.
2026-08-16 Record that any relocation in the BASIC ROM kills the display
    Section 5.2 already said this board fails when library modules move, but
    worded the rule as a size threshold: "grows past $DC50". That is wrong.
    Removing a 3 byte jsr from _system_init made CODE shrink, so it stayed
    far below any threshold, and the screen went black anyway. Reproduced
    over two flashes, with the unchanged ROM and a byte stable version of
    the same change both running - which also rules out a bad EEPROM burn.
    Three bytes less in core.o move every library module behind it: 7281
    changed bytes in CODE, 1493 in RODATA, 389 in BAS_*, 68 in SYSCALLS and
    one in VECTORS. Page alignment kept RODATA_PA in place and that did n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
2026-08-16 Drop the boot time SD mount
    _sd_mount runs the whole bring-up itself - it resets the card to idle
    and SPI mode and re-reads the layout - and LOAD and SAVE call it every
    time rather than trusting what the last access saw. Mounting at boot as
    well bought nothing and cost the card timeout on every reset with an
    empty slot, plus an "SD initializing" line on the LCD.
    OS/1 is the exception: its shell loads programs with _sd_load, which
    only tests sd_ready and never mounts, so the call moves into os1.s
    instead of disappearing.
    The three bytes the jsr occupied are padded with nop. core.o sits in
    common.lib ahead of most other modules, so shortening it relocates every
    library module in the BASIC RO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
2026-08-16 Light the drive LED through the BASIC cold start
    The RAM probe walks all of user RAM a byte at a time and the vector
    setup after it takes a while too, so the machine looks dead between the
    "C" and the first prompt. The drive light doubles as a busy light for
    that stretch.
    Both new routines sit at the end of EXTCODE and are reached by swapping
    an existing call for one of the same width - JMP COLD_START becomes JMP
    sd_coldstart, jsr sd_panelprompt becomes jsr sd_promptled. Only two
    operands change, no byte in CODE or SDCODE moves. See MEMORY_MAP.md
    5.2.1 for why that matters here.
    sd_promptled leaves the light alone while a save is still open, since
    sd_finish is about to close that file and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
2026-08-16 Keep the OS/1 ROM byte stable as well
    Adding a second "jsr _sd_init" next to "jsr _system_init" grew os1.o by
    three bytes and moved shell.o, monitor.o, opcodes.o and the whole
    library behind it. That is the change this board reacts to, so OS/1 was
    carrying the same defect the BASIC ROM had just been cured of.
    Fold both calls into os1_init in EXTCODE and let the existing call site
    point at that instead. CODE keeps its length, RODATA and RODATA_PA stay
    byte identical, and only the pinned EXTCODE block grows.
    Not yet run on the board - see MEMORY_MAP.md 5.2.1 and "make romcheck".
2026-08-16 Catch relocated code before the EEPROM is burned
    Finding out that a ROM leaves the display dead costs a burn, a boot and
    a bisect. The information needed to see it coming is in the map file, so
    check there instead: a segment the linker does not pin to a fixed offset
    must keep its start and its end, and a change may alter operands but
    must never move a byte.
    make romcheck compare the build against the reference
    make romfreeze record the current build as the new reference
    make install now runs romcheck first
    Two references are kept per project, both small enough to read in a
    diff: the image itself, and the segment list lifted out of the map. A
    project without them is reported,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
2026-08-19 Pace the VDP set-up so the screen comes up on a cold start
    At power-on the display came up as garbage, as nothing, or correct,
    differing from boot to boot, and two or three manual resets fixed it.
    Two causes, both only visible while the chip is cold.
    The TMS9918A wants about 8 us between two accesses. The set-up routines
    sit under that wherever they write a pair: 4 us between the value and
    the register number in vdp_init_text_mode, 2 us between the halves of an
    address in vdp_set_vram_addr and in vdp_enable_display. Enough for a warm
    chip, not enough for one just switched on - and those are exactly the
    writes that place the registers and the table bases, so what survives is
    a screen drawn f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
2026-08-19 Note how little room the two offset blocks have left
    EXTCODE is down to about 100 free bytes and SDCODE to about 74. Anything
    larger than that needs a new fixed block, and the only space left for one
    is $F8A2-$FFF9, which this board has never had code in. Worth knowing
    before it becomes urgent rather than after.
    Also point 5.2.1 at romcheck/romfreeze, which is how the byte comparison
    it asks for is actually run.
2026-08-19 Move the BASIC ROM reference to the image with the VDP fix
    The reference is the claim "this one runs on the board", so it follows
    the hardware, not the build. This image is the one that comes up
    reliably from cold.
2026-08-19 Bring the address tables back in line with the mapfiles
    The tables in sections 3.2, 3.5, 5 and 5.1 still described the layout of
    2026-08-10 and had drifted since. Regenerated from the ld65 mapfiles of
    the current build and checked back against them: both ROM tables now
    cover $A000-$FFFF without a gap and add up to 24576.
    What moved:
    os1 BSS ends $09D0, not $09C0 - sd.o grew from 20 to 36 bytes
    BAS_RAM BASBUF is 105 bytes now, not 79, leaving 147 free
    os1 ROM has EXTCODE and SDCODE now; free space 5218, not ~7.5 KB
    BASIC ROM every row had moved; free space 2160
    Sections 1, 2 and 4 were checked as well and are unchanged - the zero
    page split, the 64K map and the lo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
2026-08-19 Make the top level build actually rebuild
    The rules that recurse into the projects named no prerequisites, so make
    saw the .bin already on disk, declared the target up to date and never
    entered the directory. Editing anything under common/source/ therefore
    produced no rebuild at all - silently, with a clean exit. Every source
    change this session needed an rm of the binary first to take effect, and
    "make mapdoc" caught a table checked against a build that was two commits
    old for exactly this reason.
    Give both pattern rules a FORCE prerequisite so they always ask. The
    project makefiles track their sources properly through the .d files, they
    just have to be entered. Also declare the phony targ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
2026-08-19 Drop the README entries for projects that no longer exist
    The cleanup in d44eb04 removed 25 of the 39 projects the README described,
    and the numbered folders it kept were renamed. What was left told you to
    build rom/02_nop_fffc, flash rom/13_4bit_lcd and upload load/01_blink_test
    - none of which are there.
    Gone: the catalogue entries and table rows for the deleted projects, the
    "more complex programs" list, the RAM test step that used 07_mem_test and
    08_stack_test, and the 4-bit LCD step. The serial test in the warp speed
    section now points at rom/serial_wdc_irq with the message it really prints,
    since 15_serial_irq went with the rest.
    Added, because the catalogue was missing them: serial_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
2026-08-21 Drive the SN76489 data bus in play_song
    The program never wrote VIA2_DDRA. A 6522 clears its direction registers on
    reset, so port A came up as eight inputs and the "STA VIA2_PORTA" in sn_send
    loaded the output latch without a single pin driving the bus - the sound chip
    never saw a byte and the ROM stayed silent.
    Loaded over XMODEM the same code plays, which is what made this look like a
    build problem rather than a missing register write: the bootloader ROM has
    already run _system_init, and sound_init sets DDRA to $ff there. As a ROM
    nothing runs in front of it.
    Setting the same $ff here fixes the ROM and is a no-op for the loadable build,
    which finds the port configured that way already.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
2026-08-21 Add a SOUND statement to MS-BASIC
    SOUND frequency, duration - frequency in Hz, duration in hundredths of a
    second, channel 1 of the SN76489 at full volume, returning once the note has
    finished.
    The chip wants a 10 bit divider rather than a frequency, so the statement
    divides 62500 by the argument using BASIC's own float package. That constant is
    the part's 2 MHz clock over 32, and it checks out against the note table in
    sound.inc: A4 is listed there as a divider of 142, and 142 * 440 Hz = 62480.
    Dividers outside 1..1023 raise ILLEGAL QUANTITY, which puts the usable range at
    62 Hz to roughly 4 kHz.
    The two tone bytes go out before the duration is evaluated. The channel is
    still muted at tha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
2026-08-21 Confirm the SOUND ROM on hardware and retire the relocation rule
    Burned and tested on the board: picture comes up, SOUND plays, the range and
    divide-by-zero errors are reported, LOAD and SAVE still work. reference.ext.bin
    and reference.ext.segments now record this image, so romcheck measures against
    something that has actually run.
    That result also settles the question section 5.2.1 left open. This is the
    first image since the VDP fix in which code genuinely moved - the sd.o tail of
    EXTCODE by 76 bytes, plus BAS_KEY and BAS_ERR - and it works. Relocation on its
    own does not kill the display, and the rule is wrong in the absolute form it
    was written in.
    The old diagnosis is explainable rath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
2026-08-21 Add a Towers of Hanoi example for MS-BASIC
    basic/HANOI.BAS solves the puzzle for 1 to 7 disks, optionally drawing the
    pegs after every move, and clicks the SN76489 through the new SOUND statement
    as each disk lands.
    It is written against what this BASIC actually has. CONFIG_SMALL takes GET
    away, and there is no ELSE and no STRING$, so every branch is a line number and
    the padding strings are built with FOR loops. There is also no recursion -
    GOSUB has neither arguments nor locals - so the program carries the call stack
    that hanoi(n, from, to, via) would need in five arrays plus a stage number per
    frame.
    Checked before committing, since none of it can be run here: a subset
    interpreter walks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
2026-08-22 Add a CLS statement and put BYTES FREE above the card line
    CLS clears the screen and homes the cursor. It is what people reach for CLEAR
    expecting, and CLEAR is not it: CLEAR throws away variables, arrays and string
    space, resets the DATA pointer and unwinds the FOR and GOSUB stacks, and never
    touches the display.
    tty_config can have several outputs on at once, so CLS handles each on its own
    terms - the VDP through vdp_clear_text_screen, a serial terminal through
    ESC[2J ESC[H. The escape sequence goes straight to the ACIA instead of through
    _tty_send_character, which would also push the bracket and the letters onto the
    VDP as text. The LCD is left alone; it is the panel, not a console.
    The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
2026-08-23 Add a COLOR statement, because POKE cannot set a VDP register
    COLOR foreground, background - both 0 to 15 out of the TMS9918A palette,
    written to register 7. Text mode has no colour table, so the backdrop is the
    background and those two are the only colours on the screen.
    The POKE recipe that ought to do the same thing does nothing at all, and
    without an error, which took some working out. Both halves of a register write
    go to the same control port, and POKE assembles to "sta (LINNUM),y". The dummy
    read that addressing mode performs on the target one cycle before the write is
    itself a VDP access, and the chip wants about 8 us between two - so the write
    never registers and the pair never com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
2026-08-27 Add a VDP diagnostic ROM that reports to the LCD
    The BASIC ROM came up drawing the right characters through the wrong glyphs, and
    two rounds of reading the code produced two plausible theories, two fixes, two
    new bugs and no progress. The reason is that the screen is the part under
    suspicion, so it cannot be used to observe itself, and every hypothesis had to
    be judged by squinting at the damage it was supposed to explain.
    rom/vdp_diag observes it from the outside instead. It runs the cold start step
    by step and prints on the LCD:
    PRB the two bytes read back from $3FFE/$3FFF after writing $5A/$A5 there.
    $5A $A5 means VRAM takes a byte, returns it and auto-increments
    ST the st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
2026-08-27 Add an EXTCODE2 block and move COLOR into it, because relocation is real
    COLOR made the machine come up drawing the right characters through the wrong
    glyphs, permanently, and a ROM without it runs. Its code cannot be at fault: it
    never executes before the prompt. What it does do is take 25 bytes at the front
    of SDCODE, which pushes every module behind it to a new address.
    Moving the identical statement to a new block behind SYSCALLS fixes it. Against
    the ROM that was verified working, the image now differs in 25 bytes of
    previously empty ROM, 34 immediates in a CODE of unchanged length, and the token
    table. SDCODE, EXTCODE, RODATA, RODATA_PA, SYSCALLS and VECTORS: zero bytes
    different. One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
    [firmware.ext.cfg]
2026-08-27 Skip the cold/warm question after a power-on
    The choice only means something when the RAM still holds a BASIC program. After
    a power-on it does not - it holds whatever the SRAM came up with - so the
    question had exactly one sensible answer and still had to be answered by hand on
    every switch-on, with the machine sitting there until it was.
    A six-byte signature in BASBUF tells the two cases apart. It is stamped on the
    way into the first cold start and never cleared, so finding it again means the
    RAM survived, which means this was a reset rather than a power-on. BASBUF works
    for this because nothing zeroes that page at boot - the same property that
    already forces _start_msbasic to set sd_load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
2026-08-27 Freeze the reference on the power-on start ROM
    Run on the board: switching on goes straight into BASIC with no prompt, the
    reset button still asks cold or warm. That is the whole of what cff1891 changed,
    so the image is what romcheck should measure against from here.
2026-08-28 Freeze the reference on the graphics mode ROM
    Run on the board: SCREEN 1 gives a clean black screen and PLOT 128,96,15 puts a
    white dot in the middle of it, so the mode switch, the VRAM fills, the sprite
    list and the address arithmetic all do what they are supposed to.
2026-08-28 Fix the hang on the first ENTER: keep BAS_KEY under 256 bytes
    Adding LINE pushed the keyword table to 257 bytes, and program.s indexes it with
    an 8-bit Y - the compare at L2498 and the scan at L24DB that steps over the
    keyword it has just failed on. Every byte has to be reachable through one index
    register, the terminating zero included. At 257 that zero sits at offset 256, Y
    wraps to nought, the scan starts again at the first keyword and never finds an
    end.
    The first ENTER is the first moment anything is tokenised, so that is where it
    hangs. Everything before it - sign-on, LCD panel, SCREEN, PLOT - works, which is
    why the symptom points at nothing in particular.
    NULL leaves the table to m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
    [firmware.ext.cfg, load.cfg]
2026-08-28 Freeze the reference on the LINE ROM
    Run on the board: the lines are on the screen and the prompt survives ENTER, so
    both halves of this hold - the Bresenham loop and the keyword table being back
    under the limit that made the previous image hang.
2026-08-28 Freeze the reference on the paged keyword table ROM
    Run on the board with the table at 257 bytes, one past the size that used to
    hang the machine on the first ENTER. Typing works, so the scan reaches the
    terminator on the second page; LIST works, which is the other read path;
    LOAD "$" and loading and running a program work, which is a full round trip
    through tokenising and back.
2026-08-28 Freeze the reference on the CIRCLE ROM
    Run on the board. Also the first image whose keyword table is genuinely longer
    than a page, at 263 bytes, so the paging is carrying weight rather than being
    exercised at the boundary.
2026-08-28 Freeze the reference on the SPRITE ROM
    Run on the board.
2026-08-28 Add a KEY function for input that does not wait
    A = KEY(0) gives the code of a key if one is waiting and zero if none is. INPUT
    holds the machine until ENTER, so until now nothing written in BASIC could steer
    a sprite, poll for a fire button or offer a way out of a loop. With the graphics
    statements in place that was the gap holding everything else up.
    Ten bytes of code. MONRDKEY already returns carry clear when nothing is waiting
    and already reads both the serial port and the PS/2 keyboard, so the whole
    function is a call, a zero for the empty case, and SNGFLT to float the result
    into FAC the way PEEK does.
    Upstream has GET for this, but CONFIG_SMALL leaves its routine out of the build
    en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
2026-08-28 Keep Y across the graphics text renderer
    Every line typed in SCREEN 1 came back as ?SN ERROR, whatever it was, while
    PRINT from a program was fine.
    tty_read_line holds its buffer index in Y for the whole of the read loop and
    echoes each character through tty_write_byte, which saves X around the echo and
    not Y. The routines this layer replaced happened to leave Y alone, so nothing
    in tty.s ever had to say so, and gtx_render walks Y over the eight shape bytes
    and the eight colour bytes. The index was wrecked on every keystroke, so the
    line handed to the tokeniser was not the line that was typed - and it read as a
    syntax error rather than as anything to do with the screen.
    gtx_render saves an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
2026-08-28 Clear the graphics-text flag before the sign-on banner
    A power-on came up with the screen full of rubbish. Going into SCREEN 1 and back
    out cured it, and cured it for good - resets after that were clean, cold or
    warm. Only the very first initialisation was affected.
    standalone.s prints the banner to the VDP between _system_init and
    _start_msbasic, and start_select - which clears gtx_active - runs inside
    _start_msbasic. So the banner went out while the flag still held whatever the
    SRAM came up with, which is "graphics is on" in 255 cases out of 256. Every
    character of it was rendered as a bitmap cell while the machine was in text
    mode, straight across the font at $0800. SCREEN 1 then SCREEN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
2026-08-28 Freeze the reference on the graphics text ROM
    Cold started on the board with the sign-on banner readable, which is what the
    last three commits were about. Carries KEY, text drawn into the bitmap, the Y
    that the renderer was standing on, and the flag cleared before the banner.
2026-08-28 Pace the per-character VRAM address in text mode
    With the letters of the sign-on banner landing scattered - single characters
    missing or displaced out of an otherwise correct line, and the prompt itself in
    the right place - the suspect is not the font or the addressing arithmetic but
    the write pair itself.
    load_vram_char_position set the VRAM address with two stores straight at the
    control port:
    sta VDP_REG
    lda vdp_vram_address+1
    ora #VDP_WRITE_VRAM_SELECT
    sta VDP_REG
    Nine cycles between the two bus accesses at 1 MHz, against the eight the
    TMS9918A asks for. One microsecond of margin, on the hottest path in the
    machine, set up again for every single charact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
2026-08-28 Freeze the reference on the ROM without XMODEM
    Run on the board with the text where it belongs. Two results in one image: a
    CODE relocation of eleven library modules is survivable, and the scattered
    characters it produced were a one microsecond margin on the per-character
    address pair rather than the relocation itself.
2026-08-28 Freeze the reference with every VDP access paced
    Run on the board: scrolling clean, CLS clean. That closes the timing class -
    the four sites that were writing the two halves of a VRAM address closer
    together than the chip allows are all through vdp_write_address now, and the
    audit in MEMORY_MAP.md 5.5 lists every pair in the tree with the gap it leaves.
2026-08-28 The VDP routines alone reproduce it, so now move everything but them
    Moving the 231 bytes of VDP code out of SDCODE and holding the other three
    tenants still came back garbled - and sometimes with no picture at all, which
    is new. No picture means vdp_boot_init exhausted all twenty tries: vdp_alive
    wrote two bytes to $3FFE, read them back and looked for the frame flag, and
    twenty failures in a row make it give up and leave the screen dark. So the chip
    stops answering rather than merely drawing the wrong thing.
    That puts the fault inside vdp_wait, vdp_write_address, vdp_write_register, the
    vdp_boot_* cold start and vdp_alive. Not libfat32, not the BASIC SD statements,
    not the block as a whole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
2026-08-28 Move the VDP routines by whole pages, so their timing cannot change
    The mirror came back clean: libfat32 moved 25 bytes and the screen was fine.
    Together with the burn before it that settles which code is sensitive - the 231
    bytes of vdp_wait, vdp_write_address, vdp_write_register, the vdp_boot_* cold
    start and vdp_alive, and nothing else in the ROM.
    So the question stops being which block and becomes why at all, and two
    families of explanation are left. Either it is timing - a 6502 pays an extra
    cycle for a taken branch across a page boundary, so moving code by an arbitrary
    amount changes where those boundaries fall and with them the gap between two
    control-port accesses. Or it is the addr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
    [firmware.ext.cfg]
2026-08-28 Narrow the fault to one branch, and put that branch on trial
    Moving the VDP routines by whole pages came back clean, so the chip is not
    reacting to the addresses. It is reacting to cycle counts, and relocation is
    only dangerous because it changes them.
    A 6502 pays an extra cycle for a taken branch across a page boundary. The block
    holds eleven branches, and for each one it can be worked out whether it crosses
    at a given base address. Four bases have now been burnt - $F05D and $E45D ran,
    $F076 and $FEB7 did not - and exactly one branch matches good/bad/bad/good:
    the bcc at +$09E, which is "bcc @up" in vdp_boot_init, the branch taken when
    vdp_alive has passed. In both working ROMs it crosses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
    [firmware.ext.cfg]
2026-08-28 Put the VDP routines back on the address of the first failure, alone
    Four cold starts came up clean, so the BASIC SD statements move safely too.
    That is every tenant of SDCODE tried on its own, and none of them does any
    harm. Two configurations still fail: all four tenants moved together, and the
    VDP routines at $FEB7.
    Sorting the five addresses the VDP block has been burnt at by their low byte
    separates them - $5D, $5D and $60 work, $76 and $B7 do not - but five points
    are an observation, not a finding, and the branch arithmetic that would have
    explained it is already dead.
    What has never been tried is $F076 on its own. That is the address the VDP
    routines had in the very first burn that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
    [firmware.ext.cfg]
2026-08-28 Answer the decoder question with a ROM that can measure it
    Four cold starts, four garbled screens, so $F076 on its own does it and the
    first failure is explained by the address alone. Three addresses work and two
    do not, with nothing else in the image differing.
    The obvious reading is a miswired address decoder - some ROM region that also
    selects the VDP, so that merely fetching instructions there causes accesses
    nobody programmed. It fits the symptom and the data rule it out: the working
    layout $F05D-$F143 and the failing one $F076-$F15C share 206 of their 231
    bytes. Same addresses, opposite outcome. It is not that those addresses are
    poisoned; it is which instruction sits on which address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
    [firmware.ext.cfg]
2026-08-29 The probe found nothing, and one of my burns was not single-variable
    vdp_alias reports PRB 5A A5 and then 00 five times over. A plain store executed
    from $F076 or from $FEB7 causes no spurious VDP access, so the decoder does not
    glitch on the address of the storing instruction alone. The probe was too pure
    to reproduce the real thing: it only ever touched the data port at $8080, never
    the control port at $8081 with its write flip-flop, and it paced itself with
    nops instead of jsr vdp_wait - the real routines fetch vdp_wait's address in
    the cycles after every access, and that address moves with the block. Removed
    from the tree; the result is in MEMORY_MAP and the source is in the history.
    Re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
    [firmware.ext.cfg]
2026-08-29 It is the low byte, so ask whether the board reads back what was burnt
    $E3B7 - the low byte of the address that failed, in the region where two others
    worked - came back as a black screen, four cold starts running. Not even
    garbled: vdp_boot_init runs all twenty tries and gives up.
    That settles the parameter. Two completely different pages sharing a low byte
    both fail; three different pages with other low bytes all work. The region is
    not it. The low byte is.
    A0 to A7 select the byte within a page, so a marginal low-order address line -
    too slow, too much capacitance, a cracked joint - misbehaves at the same
    offsets in every page, whichever page it is. That is exactly the shape of the
    tabl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
    [firmware.ext.cfg]
2026-08-29 Ask the same question again, executing instead of reading
    rom_check walks memory with (zp),y, one byte every five cycles, in the simplest
    address sequence there is. A running program changes the address every cycle
    and in arbitrary patterns, so a marginal low-order line could pass the read
    test and still break execution.
    rom_exec puts the same 21-byte routine at the five addresses the VDP routines
    have been burnt at. It uses nothing but immediates and one relative branch, so
    all five copies are byte for byte identical and must return byte for byte
    identical results - verified against the built image. Each call runs 256
    iterations of an arithmetic chain and each address is called 64 times, w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
2026-08-29 The ROM reads back what was burnt
    rom_check reports SUM 85E4 and five zeroes. The sum matches the one taken over
    the .bin on the host to the byte, and every one of the five blocks comes back
    whole, tag and all. So the board hands out what was put into it, at least when
    asked politely.
    That clears a hard fault - a dead cell, a broken address line, a bad socket
    joint - and leaves only the caveat the section already carried: this is a
    sedate read loop, and a line that is merely marginal can pass it. rom_exec asks
    the same question with the CPU fetching instructions instead.
2026-08-29 Stop rebuilding the failure and go measure the real one
    rom_exec reports R 9B9B9B9B9B and I 0000000000. The board fetches and executes
    correctly at all five addresses, including the two where the VDP routines fail,
    across some two hundred thousand instruction fetches each. Together with
    rom_check that clears the ROM in both directions. Both check ROMs are out of
    the tree again; the results are in MEMORY_MAP and the sources in the history.
    Three measurements have now come back negative, and between them they cut the
    search down. Page boundaries of all eleven branches across five burns show no
    pattern, so cycle counts inside the block are out. A store executed from the
    bad address causes no s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
    [firmware.ext.cfg]
2026-08-29 The first address written to the chip does not take, so map the low byte
    vdp_diag built with its VDP routines at $E3B7 reproduces the whole failure
    outside BASIC, in 1.2 KB of diagnostic ROM, and the LCD says where it is.
    ST DA has bit 7 set, so the chip is clocked and producing frames - the black
    screen is not a dead VDP. PRB comes back EF CB instead of 5A A5, and that is
    the simplest access there is, sitting before everything else: the very first
    address pair written to the chip does not arrive. M1 0000 follows from it, the
    font copy being wrong from its first byte, and SH FFFF says what is in VRAM is
    not the font misplaced, it is not the font at all.
    That names the part: the control port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
    [firmware.ext.cfg]
2026-08-29 The map splits on A7 against A6, which is what a coupled pair looks like
    vdp_lobyte came back with a clean division. Sorted by the top two bits of the
    low byte: A7 and A6 equal always passes ($00-$30 and $C0-$F0), A7 and A6
    different always fails ($80-$B0 solidly, $40-$70 unreliably). That is the shape
    of two coupled neighbouring lines - when they agree no current flows between
    them, when they differ one drags the other. A high-resistance bridge does
    exactly that, and it also explains why the ROM stayed clean: a 6502 takes read
    data late in the cycle, so a sluggish address edge has settled by then, while
    the VDP's decoded select is the tight path.
    Two flaws in that map, both mine. Page and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
    [firmware.ext.cfg]
2026-08-29 The fault is not deterministic, so average instead of reporting once
    vdp_lobyte2 came back with two rows that differ from each other and different
    numbers on every cold start. That is the finding, and it matters more than the
    map: the fault is intermittent. A single pass therefore measures noise, and the
    clean A7-against-A6 split from the first map was partly luck - fifteen runs
    cannot estimate a rate that sits somewhere between zero and one.
    It is also an argument in itself. Logic fails reproducibly; coupling, edges and
    propagation delays do not. An intermittent fault points away from anything the
    assembler can be blamed for.
    So the ROM no longer reports once. It runs round after round un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
2026-08-29 No bridge on the board, and a third confound in my own probe
    Measured: 270k between A6 and A7, and the same 270k between A8 and A9 and
    between A10 and A11. The same value on every neighbouring pair is the leakage
    path through the CMOS inputs hanging off the bus, not a connection. A real
    solder bridge would be a few hundred ohms and would be on one pair. The
    coupling explanation is finished, and it cost no burn to finish it.
    The sample output also shows structure - $40 and $48 never fail in either set,
    $50, $58 and $80 through $98 always fail in both - with the two rows
    contradicting each other in between: 14 against 4 at $60, 6 against 0 at $70,
    6 against 13 at $A0.
    That contradiction has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
2026-08-29 The pages are innocent and the low byte is not a bit pattern, so sweep it
    With a retrace before every probe the two rows converged over 141 rounds:
    $50, $58, $80, $88, $90 and $98 fail, everything else fails at most once in
    141. Two different pages give the same answer, so the pages are innocent, and
    the low byte decides reliably once the phase is held still.
    It is not a bit pattern, though. No single address bit and no pair of bits, at
    any offset into the probe, separates the failing low bytes from the passing
    ones, and neither does the number of address lines that switch between the port
    access and the next fetch. What the map shows is two bands, roughly $50-$5F and
    $80-$9F, and sampling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
2026-08-29 Same probe, two memories, because the sweep changed two things at once
    vdp_sweep reports N=0015 with nothing but dots: twenty-one rounds over 192
    addresses and not one failure out of RAM, where $50, $58, $80, $88, $90 and $98
    fail every time out of ROM.
    Tempting as "RAM clean, ROM not" sounds, it cannot be read that way yet. Two
    things changed between those two ROMs and both changes are mine: the sweep runs
    out of RAM, and it also uses a different probe - straight-line code paced with
    nops, where vdp_lobyte2 called two subroutines inside itself. Either could be
    what matters.
    vdp_romram changes exactly one thing. The sweep's relocatable probe is used for
    both rows. Six copies of it are link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
    [firmware.ext.cfg]
2026-08-29 RAM is clean where ROM is not, so now ask what actually comes back
    379 rounds with one probe in two memories. Out of RAM nothing fails at any of
    the six low bytes; out of ROM, $80, $90, $98 and $60 fail and $50 and $40 do
    not. Same instructions, same low bytes, same phase, so the only difference left
    is which part the bytes are fetched from. The caveat belongs with it: on this
    board RAM lives below $8000 and ROM above, so "ROM against RAM" is unavoidably
    also "A15 set against A15 clear", and the VDP itself sits with A15 set. This
    board cannot separate those.
    $50 and $60 also swapped sides. With the probe built from subroutines $50
    failed and $60 did not; with the straight-line probe it is t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
2026-08-29 It is not rubbish, it is off by exactly one
    The failing ROM copy returns A5 20 and keeps returning it. $5A went to $3FFE
    and $A5 to $3FFF, and reading back from $3FFE gives the second value written
    followed by the contents of $0000, which is where the VRAM pointer wraps to
    after $3FFF. So the read pointer stood at $3FFF instead of $3FFE. Reproducible,
    with no noise in it at all.
    Two causes fit that, and they can be told apart: the low address byte arrived
    as $FF instead of $FE, which is one data bit on the way to the control port, or
    there was one access too many on the data port and it stepped the pointer once
    extra.
    Two bytes cannot separate those, so the probe now writes sixteen, to
    $3F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
2026-08-29 Pin the address the working ROM depends on, and stop burning for now
    The sixteen-byte probe reports B 00, which means no ROM copy failed at all -
    $00 is not one of the six low bytes, and the four bytes beside it are
    uninitialised RAM, which is why they never change. Three probes with the same
    purpose have now given three different answers: the one built from subroutines
    fails at six low bytes, the straight-line one at four, and this one at none. So
    it is not a block's address that decides but where the individual instructions
    inside it fall, and this probe apparently puts none of them anywhere awkward.
    What stands across every burn is smaller but solid. The same bytes never fail
    out of RAM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
2026-08-29 os1 is explained by its address, and here is a ROM for the analyser
    os1 has never shown this fault, and its map file says why: its vdp_wait sits at
    $EC00. msbasic.o contributes nothing to SDCODE there, so vdp.o comes first in
    the block and inherits its page boundary - low byte $00, which was solidly good
    in every map that was measured.
    The likelier-sounding explanation, that os1 simply brings the screen up much
    later - two one-second waits before it prints anything, and the VDP not touched
    until _run_shell - does not hold. In vdp_romram the same copies kept failing
    through 379 rounds, minutes after power-on, with no drift at all. It is not a
    warm-up effect.
    rom/vdp_scope is built for a log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
2026-08-29 The 74HC138 is not clock-qualified, and the race is now visible sample by sample
    /CSW and /CSR come from a single 74HC138. A capture that also carries its
    enable pins - G1 on 6, /G2A on 4, /G2B on 5 - shows the whole thing:
    t(ns) phi2 R/W /CSW /CSR G1 /G2A /G2B
    -42 0 0 0 1 1 0 0 write in progress
    +0 0 1 1 0 1 0 0 R/W rises, enable still on
    +42 0 1 1 1 1 1 0 /G2A drops out, decoder off
    R/W goes high one sample before /G2A removes the enable, and in that window the
    decoder is still on while R/W already says "read" - so it pulls /CSR low. The
    glitch, watched directly rather than inferred.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
2026-08-29 A symmetric clock does not fix the glitch, but it clears the way for the fix
    The 29% duty is explained and gone. It came from a 4 MHz oscillator divided by
    a CD4017, which frees one output per count step - so dividing by four gives one
    high phase against three low ones. Not a wiring mistake, a property of the
    divider. Replaced with a real 1 MHz oscillator and no divider: phi2O now
    measures 1.000 us period, 500 ns high, 50% duty.
    The glitches are unchanged. Over 111 marker pairs the copy at $40 collects none
    or one and the copy at $90 collects one to six, exactly as before. That was to
    be expected - the race inside the '138 is about propagation delay, not the
    shape of the clock. The clock wa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
2026-08-29 The 74HC00 removes every glitch, so put BASIC back on the worst address
    Six seconds of capture, 155 marker pairs, after gating both strobes with phi2
    through a 74HC00: six /CSW and two /CSR in every window of both copies, and
    zero glitches in all four columns. The strobes are 500 ns now instead of 958,
    sitting in the data phase where they belong. Of the 43,700 spurious read
    strobes a capture used to hold, none are left - the 144 short pulses the script
    still finds across the whole recording are all inside the first millisecond,
    which is the analyser settling. The copy at $90, which failed in every single
    window before, now behaves byte for byte like the one at $40.
    Also recorded, because it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
    [firmware.ext.cfg]
2026-08-29 Confirmed on the board: the crutches come out
    The image that gave four black screens now runs, across several cold starts.
    Same ROM, bit for bit; different board. The software was never at fault.
    So the crutches go. The rule that new code had to live in EXTCODE2 is lifted -
    db6502_sdbasic.s, CLS and everything else in SDCODE may grow again, library
    modules may shift, and statements can sit where they belong. EXTCODE2 stays as
    a block because the code in it is fine, but it is no longer a constraint. The
    vdp_wait = $F05D assertion in standalone.s is removed; it had exactly one
    purpose and that purpose is gone. VDPCODE is out of firmware.ext.cfg and the
    VDP routines are back in SDCODE, which p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
    [firmware.ext.cfg]
2026-08-29 Scroll the graphics screen instead of wrapping to the top
    Text in SCREEN 1 used to wrap to the top and overwrite when it ran off the
    bottom, because scrolling looked too expensive to be worth it. Now that the
    board no longer punishes code for where it sits, it is worth doing properly.
    A character row is exactly one 256-byte page of the bitmap - the byte holding
    pixel (x,y) is at high = y>>3, low = (x & $F8) | (y & 7), so across a row the
    high byte is the row number and the low byte runs the full 0..255. Scrolling is
    therefore 23 page moves in the shape table and 23 in the colour table, with the
    row that comes free blanked and set to the text colour afterwards.
    It costs about a third of a s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
2026-08-29 Hand every register back from the scroll, or the line being typed is lost
    Scrolling put stray pixels on the screen and then never stopped: after forty
    lines the machine printed OK and carried on scrolling with rubbish like
    "BREAK --:hhhh=". One cause for both.
    gtx_scroll saved nothing. It hangs off the newline path, where vdp_newline and
    the text mode scroll behind it save A, X and Y - and they have to, because
    tty_read_line keeps its buffer index in Y and the line being typed is built on
    it. Coming back with a different X or Y corrupts that line, and since the
    prompt is part of the line the machine prints nonsense and keeps scrolling. The
    stray pixels are the same corruption seen from the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
2026-08-29 Two BASIC programs for the d-pad, and a note on how to read it
    The four buttons sit on VIA2 port B, active low, and need nothing set up:
    _blink_init runs during boot and leaves those bits as inputs, so PEEK(34816)
    reads them from BASIC as it stands. Bit 7 is the LED and bits 0 and 1 are
    outputs too, so writing to that port is best avoided.
    basic/DPAD.BAS steers a sprite with the pad - shape into VRAM with VPOKE,
    position with SPRITE, twenty lines.
    basic/SNAKE.BAS is the game. The field is 8x8 cells and each one is drawn with
    eight VPOKEs rather than sixty-four PLOTs: a character row of the bitmap is one
    page of VRAM and its eight rows of pixels are eight consecutive addresses, so a
    cell is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
2026-08-29 Retire the workarounds now that the fault behind them is gone
    A dozen comments across the tree still told the reader that moving code kills
    the display, and two places still carried dead padding to make sure it never
    happened. That fault was a race in the address decoder and it has been fixed in
    hardware, so the claims are wrong and the padding is pointless.
    The padding is gone: three nops in core.s where a "jsr _sd_init" used to be,
    and twenty-nine in db6502_extra.s holding the place of the cold-start prompt.
    Thirty-two bytes, and CODE now ends at $DA92 with RODATA, BAS_VEC, BAS_KEY and
    BAS_ERR all thirty-two bytes lower. That is precisely the change this board used
    to answer with a dead s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
2026-08-29 Freeze the relocated image: half the ROM moved and it runs
    The hardware fix had been proven by putting the VDP routines alone on an
    address that used to kill the display. Retiring the padding gave it the larger
    case: CODE ends thirty-two bytes earlier and RODATA, BAS_VEC, BAS_KEY and
    BAS_ERR all sit thirty-two bytes lower - the shape of change that started this
    whole thing on 10.08.2026.
    Burnt and confirmed on the board, together with DPAD.BAS and SNAKE.BAS. So the
    reference moves to this image: rom/microsoft_basic/reference.ext.bin at
    b8205cb94386e5598264d001d530b49e, and the segment list with it. romcheck reads
    clean against it again, which puts the tool back to reporting only what a
    futu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
2026-08-29 Let Ctrl+C actually break, instead of reading the key and dropping it
    Ctrl+C never worked. The keyboard side was innocent all along: the controller
    sends $03 for it, exactly as it sends $18 for Ctrl+X, and the interrupt handler
    picks that second one off as a system break before it reaches the buffer, which
    is why Ctrl+X always did work.
    The fault was in ISCNTC, and the comment sitting next to it said so:
    ISCNTC:
    jmp MONISCNTC
    ;!!! *used*to* run into "STOP"
    Upstream gives every target its own ISCNTC and ends it by running into STOP -
    that fall-through is what turns a detected Ctrl+C into BREAK. This port
    replaced it with a jump to MONISCNTC, which only reports in the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
2026-08-29 Move the cursor only for characters that were actually drawn
    The console came up left aligned, then indented everything by a column from
    the sign-on onwards, and the indent vanished again after the first program line
    was typed. All three from the same place.
    vdp_write_char was vdp_out_char followed by an unconditional
    vdp_advance_char_position. vdp_out_char takes a line feed to vdp_newline and a
    carriage return to a bare "column := 0", so both come back with the column
    already at nought - and then the advance put it at one. BASIC sends both for
    every newline, so from its sign-on onwards every line started a column in. The
    indent disappeared after the first typed line because tty_read_line e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
2026-08-29 Freeze the console fixes: Ctrl+C, the indent and backspace
    Three fixes confirmed on the board together - Ctrl+C now breaks a running
    program, the console is left aligned from the banner to the prompt to the
    program lines, and backspace reaches the first character of a line. The
    reference had been two of them behind, so it moves to this image:
    3587df0c6b563f0cd1f8995655cf332c, with the segment list beside it.
    All three were the same shape of bug: a routine doing one step too many or one
    too few, in text mode only, where the graphics path had it right. That is worth
    noticing - gtx_* was written recently and against the text-mode code as a
    reference, and it came out correct three times where t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
2026-08-29 Wrap the line instead of piling up in the last column
    Text mode stopped dead in column 39: vdp_advance_char_position refused to move
    past LINE_LENGTH-1, so every character after the fortieth of a line landed in
    the same cell, one on top of the other. It now wraps through vdp_newline, which
    puts the column back to nought, moves down a row and scrolls when there is no
    row left.
    Graphics mode had the same fault in a different shape. gtx_write_char sent the
    column back to nought at the right edge but left the row alone, so a long line
    overwrote itself from the left. The overflow case now goes to
    gtx_newline_active, which is what a line feed already did - the two used to
    share the "column := 0"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
2026-08-29 Send a BASIC program down the wire, one line at a time
    LOAD "@" takes the program from the ACIA instead of the card, and
    tools/basicsend.py sends it from the Mac. INLIN is diverted the same way
    LOAD from the card diverts it, so the lines go through the interpreter's
    own tokeniser and what travels is plain text - the same text LIST prints
    and the same text a .BAS file holds.
    No new keyword: LOAD "$" already existed for the directory, so "@" goes
    next to it. sd_getname reports "not a file name" in the carry as before
    and leaves the character itself in A, which is four bytes and saves
    shifting every function token behind a new keyword.
    One line, one ACK. Not for the wire's sake - 19200 baud i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
2026-08-30 Say what a wedged serial port is, instead of a traceback
    pyserial raises a bare termios error out of its constructor when the
    driver refuses tcsetattr, which tells the user nothing and points at this
    tool. Catch it and say what it is: not an argument this tool passed - a
    no-op tcsetattr that writes back what it just read is refused too, and
    stty fails identically - and what actually clears it.
    [basicsend.py]
2026-08-30 Never wait on the wire where Ctrl+C cannot reach
    LOAD "@" hung the machine when it was left waiting with nothing at the
    other end: cold start was the only way out, Ctrl+C did nothing, Ctrl+X
    still worked because the keyboard interrupt knows nothing about any of
    this.
    The 6551 holds its transmitter off while /CTS is high, and /CTS comes
    from the far end's RTS - net 61 wires U5 pin 9 to J2 pin 4 - so with the
    port closed over there not one byte leaves, and _handle_acia_irq bails
    out at its own cts_high branch. _acia_write_byte then spins forever once
    the transmit ring is full, with no way out. An idle receiver repeating
    its ACK every 0.54 s fills 256 bytes in about two minutes and stops
    there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
2026-08-30 Re-arm the transmitter instead of only holding the ring down
    Capping the ring at one byte stopped the transfer starting at all.
    With acia_tx_irq=1, _acia_write_byte does exactly one thing the ACIA can
    see: it writes the command register, which arms the transmit interrupt.
    The byte itself only ever reaches the chip from the interrupt handler. The
    version before the cap wrote that register every 0.54 s; the capped one
    wrote it once - and that once fell while /CTS was high, with no
    transmitter able to act on it. When /CTS later drops, nothing arms it
    again, so the queued ACK sits there for good.
    ser_ack now re-arms when the ring is busy rather than returning. The ACIA
    sees the same sequence i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
2026-08-30 Start a transfer with both rings empty
    A cancelled transfer leaves an ACK and a CAN in the transmit ring that
    never went out, because the 6551 does not transmit while /CTS is high and
    /CTS comes from the far end's RTS. With the ring capped at one byte, the
    next LOAD "@" then sees a busy ring and never sends an ACK at all - and it
    stays that way until the machine is power cycled, which is why testing
    Ctrl+C and then testing an upload could not both work in one sitting.
    Getting those two bytes out is no better: a CAN arriving late tells the
    host that the transfer it has only just started is off.
    ser_load therefore empties both rings before anything else, briefly with
    interrupts off - the han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
2026-08-30 Freeze the serial load path, this time with the wire cleaned up
    Burnt and confirmed on the hardware, all three in one sitting and without
    touching the power switch: an upload runs, Ctrl+C gets out of a LOAD "@"
    with nothing at the other end, and an upload straight afterwards runs
    again. That last one is what the ring flush is for - it was dead before.
    Reference moves to 3985b9e718230c4feab1c40d36283564.
2026-08-30 Send a listing back up the wire with SAVE "@"
    The mirror of LOAD "@", and it works the way SAVE to the card works:
    MONCOUT is diverted and LIST runs over the whole program, so what leaves
    is the text LIST prints, character for character. tools/basicrecv.py
    catches it.
    No handshake in this direction and none is wanted. The machine is the slow
    end - composing a line takes it longer than 19200 baud takes to carry one
    away - and the host has nothing to keep up with. One EOT ends the listing,
    the same byte LOAD "@" takes as "no more lines".
    What does have to be waited for is room in the transmit ring, on nearly
    every character, and that is the same trap as before: with nothing holding
    the port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
2026-08-30 Freeze SAVE "@"
    Burnt and confirmed: a listing comes back over the wire and matches what
    LIST shows, the drive light goes out at the prompt, and an upload straight
    afterwards still runs - all in one sitting, no power cycle in between.
    SAVE "@" with nothing listening turns out not to block at all: the FTDI
    leaves its RTS asserted after the port is closed, so /CTS stays low and the
    6551 sends the listing into the void and reports OK. Nothing to fix - a
    one-way direction has no way to know whether anyone wrote it down, and the
    confirmation is the receiving tool's own output.
    Reference moves to d4da0f0f19036fd1a667a2efcb368f86.
2026-08-30 Commit a built JP6502Control.app alongside the source
    dist/JP6502Control.app is the Release build, universal and signed to run
    locally, so the app can be started from a checkout without opening Xcode.
    It is a committed build rather than a released one, with what that costs: it is
    only as current as the last time somebody refreshed it, every refresh leaves
    another 2.9 MB in the history, and the ad hoc signature is only good on the
    machine that produced it - another Mac holds it at Gatekeeper until it is
    opened once from the context menu, or rebuilt there. The README says how to
    refresh it.
2026-08-30 Bring the README in line with what is actually in the repository
    The folder inventory had drifted from the tree it describes. Corrected:
    - the `AVR` section went, along with the folder it documented,
    - the `Arduino` section no longer links to a README that is not there,
    - the Schematics list named a clock module, a 555 troubleshooting circuit and
    three address decoder projects; the folder holds `65C02_Computer`,
    `DB6502_v002` and the bills of material,
    - `Software` was described as four folders and is six: `basic` and `tools` were
    missing,
    - the bootloader and OS are no longer "coming soon" - `os1` builds and the
    TO-DO has said so for a while,
    - the keyboard link pointed at an ancho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
2026-09-20 Track the build flags, and build the shared objects before the projects
    Two faults in the makefiles, both found while moving the machine off 1 MHz.
    Objects only depended on their sources, not on the flags they were built
    with. Building with another CLOCK_MODE or ACIA_TX_IRQ therefore reassembled
    nothing but what had changed on disk and linked everything else as it stood -
    a 2m ROM carrying 1 MHz delays, with no warning anywhere. Every object now
    depends on a file holding those flags, rewritten only when they differ, so a
    build that changes nothing still rebuilds nothing. It is written a second
    after the objects it invalidates because make 3.81, the one macOS ships,
    keeps file times to the s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
2026-09-21 Import Combine where PortPicker uses it
    The port list refreshes off a Timer.publish, whose type comes from Combine.
    SwiftUI re-exports enough of it for the expression to compile, but a stored
    property of a type the file has not imported draws a warning on every build -
    four of them, twice each for Publishers and Autoconnect.
2026-09-21 Refresh the committed JP6502Control.app
    Rebuilt from the four commits before it, so the copy in dist has the clock
    mode picker and reads its output from the left.
    The path the app falls back to for the checkout is baked in at build time and
    moves with it: this build was made at Documents/8Bit/6502/JP6502, where the
    last one was made at the checkout's old home under Documents/Arduino. Neither
    is more correct than the other - Settings is what decides it on a machine
    where the guess is wrong.
2026-09-25 Pace SNAKE with a VIA timer instead of the speed of BASIC
    The game had no delay of its own: it moved as fast as the interpreter could
    get round the loop. At 1 MHz that happened to be playable; at 4 MHz the snake
    ran four times as fast. A counted delay loop would only have moved the problem
    - it would need guessing again after every oscillator swap, and a step that
    eats does more work than one that does not, so the pace would stutter too.
    Each step now waits on timer 1 of the VIA at $8800, which nothing else in the
    firmware uses. It runs free with a 5 ms period, and a step lasts SP of those
    milliseconds. A step that already took longer finds the flags waiting and
    falls straight through, so t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
2026-09-26 Work out the SN76489 notes for the clock the ROM is built for
    The sound chip runs on the CPU oscillator, but the note table in
    sound.inc and SOUND_CLOCK in db6502_extra.s were fixed values for a
    2 MHz part. At 4 MHz the startup chord, BEEP and SOUND all played an
    octave higher than they said; SOUND 440 gave 880 Hz.
    sound.inc now computes every divider from the note's frequency (equal
    temperament, A4 = 440 Hz) and clock_mhz, rounded to the nearest; notes
    whose divider does not fit in ten bits stay 0, as before. The slow and
    250k modes keep the 2 MHz values. The old table also truncated instead
    of rounding, so many notes were a step off, and it was broken around
    octave 6/7: A#6, B6 and C7 wer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
2026-09-26 Add GeckOS-V2 as a submodule
    jp112sdl/GeckOS-V2, a fork of André Fachat's GeckOS with a port to this
    board in arch/jp6502: the multitasking OS runs from the ROM, with a shell
    on the VDP console and one on the serial line, and loads its programs
    from the SD card. The README says how to build it and where the port is
    described.
2026-09-26 Switch the speaker on only once the SN76489 is quiet
    The SN76489 has no reset and plays whatever its registers came up with
    until sound_init silences it, which the speaker, wired straight to the
    chip, let through from power-on. The speaker now sits behind a 100µF
    capacitor and in series with a 2N7000 whose gate is CB2 of VIA2, pulled
    down: after a reset CB2 is an input and the speaker is off. sound_init
    drives CB2 high after silence_all. play_song, which also runs as a ROM
    with nothing in front of it, silences the chip itself and does the same.
    Software/README.md describes the circuit.
    MEMORY_MAP.md follows the ten bytes this adds to CODE in os1 and
    microsoft_basic.
    GeckOS-V2 moves to the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
2026-09-26 Drive CB2 low to switch the speaker on
    The pull-down on the speaker's MOSFET did not keep it off after a reset:
    a 6522 other than the W65C22S has a pull-up on CB2 when it is an input,
    and against 10k that left the gate at 2-3 V. The board now drives the
    MOSFET through a second one as an inverter, with CB2 pulled up, so the
    speaker is off after a reset with every 6522 and on while CB2 is low.
    SPEAKER_ON in sound.inc is CB2 as a manual output, low, which
    sound_init and play_song pick up; Software/README.md describes the new
    circuit.
    GeckOS-V2 moves to the commit that does the same in its kernel.
2026-09-26 Hand CC65_HOME to make from JP6502Control
    On this install ca65 has no usable include path compiled in, so the
    .macpack longbranch that every cc65-generated .s starts with fails with
    "Cannot open include file 'longbranch.mac'", and cc65 cannot find its
    own headers either. The app now finds the cc65 prefix - next to the bin
    holding the ca65 in use, then the usual prefixes - checks that
    asminc/longbranch.mac is under it and passes it to make as CC65_HOME,
    which covers asminc, include, lib and cfg at once.
    Settings shows the path with a Detect button and warns when the folder
    is wrong; the Build tab shows it too. macOS/README.md explains why, and
    the built app in macOS/dist is updated.
    Co-Auth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
2026-09-26 Update GeckOS-V2: DS3231 clock, time at boot, screen colours
    A DS3231 module on VIA1 (SCL on PA0, SDA on PA1) gives the files GeckOS
    writes the time they were written, and init shows the time when the
    system boots. date shows and sets the clock, i2cscan lists what answers
    on the bus. The screen colours are build options now.
2026-09-27 Check the memory map in a copy of Software
    MEMORY_MAP.md describes the default clock. mapdoc in Software itself
    rebuilt build/rom for that clock, or - with the board's CLOCK_MODE
    passed - failed on every row, the delay loops making those ROMs a few
    bytes longer. JP6502Control now rsyncs Software, without its build
    folder, into ~/Library/Caches/JP6502Control/mapdoc and runs the check
    there for the default clock; the ROMs for the board stay as they are.
    The copy keeps its build folder, so later checks are incremental.
2026-09-27 Show the whole memory map in the README
    The section listed only where each chip starts. It now has a diagram of
    the 64K, the window each chip takes with its registers and the address
    bit that selects it, the free slots in the I/O area, and the RAM as the
    firmware divides it - taken from firmware.ext.cfg and meminfo.txt
    rather than from the schematic, which no longer matches the board.
2026-09-30 Pick the ROM bank with switches on the flash's A15-A17
    The W29C020 holds eight 32 KB images and the board used one. With A15-A17
    on DIP switches and pull-downs, a reset starts MS-BASIC (bank 0), GeckOS
    (bank 1) or the minimal bootloader (bank 2). Schematics/ROM_BANKS.md has
    the wiring, the banks and how to flash one without erasing the others.
    JP6502Control's Flash tab takes a ROM bank for writing and verifying: it
    sets the offset, writes without erasing, and follows the file, so the
    GeckOS ROM handed over from its tab lands in bank 1. Without a bank, a
    write that would erase the whole chip asks first.
    Also Schematics/IO_DECODER_7F00.md: a plan, not built, for decoding the
    I/O into the pag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
2026-10-02 Find USB keyboards on a PS/2 adapter reliably
    The controller left CLK and DATA floating for its first second, and a
    keyboard that does USB as well decides from those lines at power-up
    whether to talk PS/2 - so it often came up as USB and was not found.
    The pull-ups now go on first. Instead of a single ECHO at one second,
    the controller waits for the keyboard's self-test ($AA), asks a keyboard
    that is already running, and gives a slow one up to 2.5 s. Any answer
    to ECHO counts, $FE included, which keyboards that do not know the
    command send; only silence means no keyboard. Three tries, 50 ms each.
    The status still comes no earlier than one second after power-on.
    Also ignore the build output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
2026-11-02 Load and save BASIC programs on a floppy drive, device 8
    LOAD "NAME.BAS",8, SAVE "NAME.BAS",8 and LOAD "$",8 go to a floppy
    drive on the ACIA, the way a C64 talks to its 1541. The drive is to be
    a PC floppy with a Raspberry Pi Pico of its own, behind a switch that
    otherwise connects the FTDI; Schematics/FLOPPY_PICO.md has the plan,
    the wiring and the protocol. Without ",8", LOAD and SAVE use the card
    as before.
    The protocol is the line protocol of LOAD "@" and SAVE "@" with a
    one-line command in front - "L NAME BAS", "S NAME BAS" or "$" -
    which the drive answers with a status line the way a 1541 does.
    Anything but "00,OK" is shown as, say, "?62,FILE NOT FOUND" on the
    screen and the LC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
2026-11-02 Repeat the floppy command when the drive comes up late
    Typing LOAD "$",8 before starting drivesim.py still ended in
    ?DEVICE NOT PRESENT on the board, while the other order always worked.
    Re-arming the transmitter while BASIC waits did not help: the 6551 does
    send the command once drivesim.py opens the port and the FTDI pulls
    /CTS low, but the Mac loses the first byte while it is still setting
    the port up. With -v only the CR after "$" arrived.
    A drive that has just come up now sends ENQ ($05). If BASIC is waiting
    for the first status line, it empties both rings and sends the command
    again (disk_command). At the second answer of a SAVE an ENQ is
    ignored - the drive has lost the listing, and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
2026-11-03 Pico firmware for the floppy drive, with tests on the Mac
    Arduino/floppy_pico/floppy_pico.ino is the drive's own controller: a
    Raspberry Pi Pico on the 6551 that runs a 3.5" PC drive through
    Adafruit_Floppy, with SdFat on top. It follows tools/drivesim.py step
    for step, with a disk in place of the folder - the same commands,
    status lines, line handshake and ENQ after start. A program is read
    whole before 00,OK and written only after EOT. A changed disk is read
    in again (DSKCHG), the motor stops after 3 s without a command, and
    the USB port logs every command; typing v there adds every byte and
    head step.
    Adafruit Floppy 0.6.1 writes every disk it detected itself at the bit
    rate of 1.44 MB,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
2026-11-04 Read floppies on the board: own track layer, the fork's SdFat
    The firmware of 380139c mounted no disk on the board, and would have
    written none properly.
    READ needs its 4.7k pull-up: Adafruit Floppy leaves the pin without a
    pull, and its capture waits for flux with interrupts off and no time
    limit, so without flux the Pico hung for good at the first track. The
    firmware now looks for edges on READ before every read and answers
    21,READ ERROR instead. Before a write it makes sure the disk is still
    in, as write_track waits for the index pulse the same way.
    arduino-cli links the SdFat 2.3.1 that comes with the RP2040 core, not
    the Adafruit fork. That one has no FAT12 and wants a partition table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
2026-11-04 Keep BASIC waiting while a SAVE writes, and step the head faster
    Saving a longer program ended in ?DEVICE NOT PRESENT although the file
    came out complete: BASIC waits ten seconds for the second answer, and
    writing took longer. The ten seconds run from the last byte received,
    and after the listing BASIC passes over an ENQ, so the drive now sends
    one every two seconds between tracks. The ROM stays as it is.
    The head took 22 ms a track: Adafruit Floppy waits twice
    step_delay_us / 1000 + 1 ms for each step. With step_delay_us at 1000
    that is 4 ms; a 3.5" drive manages 3.
    The new scenario slowsave makes writing take twelve seconds, and fails
    without the ENQs. For that the mock FatVolume writes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
2026-11-04 Do not read a floppy track a SAVE fills whole
    A write used to read the whole track first, only to overwrite it. Now
    hold() just takes the track over, and fill() reads what is missing
    once, when a read asks for it or the track goes back to the disk. The
    decoder leaves sectors already marked valid alone, so those written
    stay as they are. A 40 KB file takes 4 revolutions of reading, not 7.
2026-11-04 Keep track 0 of the floppy held beside the data track
    A SAVE jumps between FAT, directory and data, and with a single track
    held every jump meant writing one track and reading the next. Disk now
    has three places: one for each side of track 0, where boot sector,
    FATs and directory live on 720 KB and 1.44 MB disks alike, and one for
    any other track. Track 0 stays held from one command to the next,
    until DSKCHG says the disk came out. syncDevice() writes the data
    first, then FAT and directory.
    A SAVE of 5 KB now reads 1 to 3 revolutions instead of 6 to 8, one of
    40 KB a single one instead of 4, and LOAD "$",8 on a disk just read in
    none at all. It costs 18 KB of RAM, leaving 32 KB free.
    Direc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
2026-11-04 Say in FLOPPY_PICO.md what the switch takes on this board
    The FT230X sits on the board, runs off the board's 5 V and drives RxD
    and /CTS itself, so pins 12 and 9 of the ACIA have to be separated from
    the board before the Pico can take them over - the plan left that out.
    The section now gives a way to do it without touching the board, the
    pinout of J2, which wire goes where, the 1k in the Pico's TX line and
    why J2's 5 V stays away from the Pico.
