jp112sdl/JP6502/images/monitor.jpeg

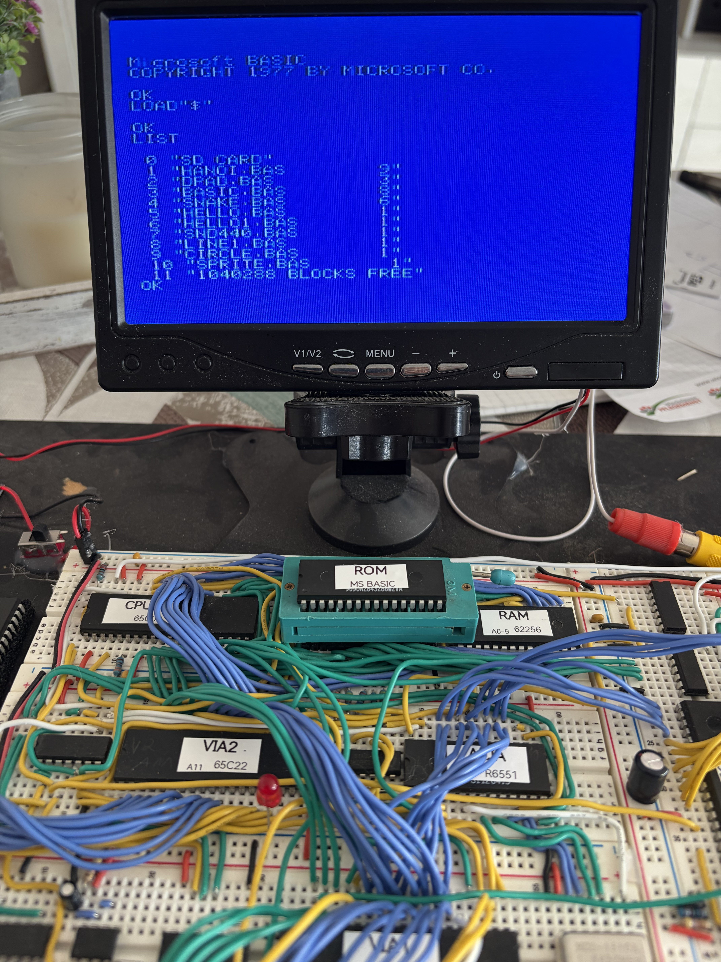
[picture p1: images/monitor.jpeg]
images/monitor.jpeg
